RobFro96/Arduino-Mega-6502/eagle-6502/6502_arduino/Version 1 Errata.txt

- Move back USB connector by 3 mm
- Mirror oscillator footprint
- connect PA2 directly to BOOT button
