RobFro96/Arduino-Mega-6502/eagle-6502/base v2/base.pdf

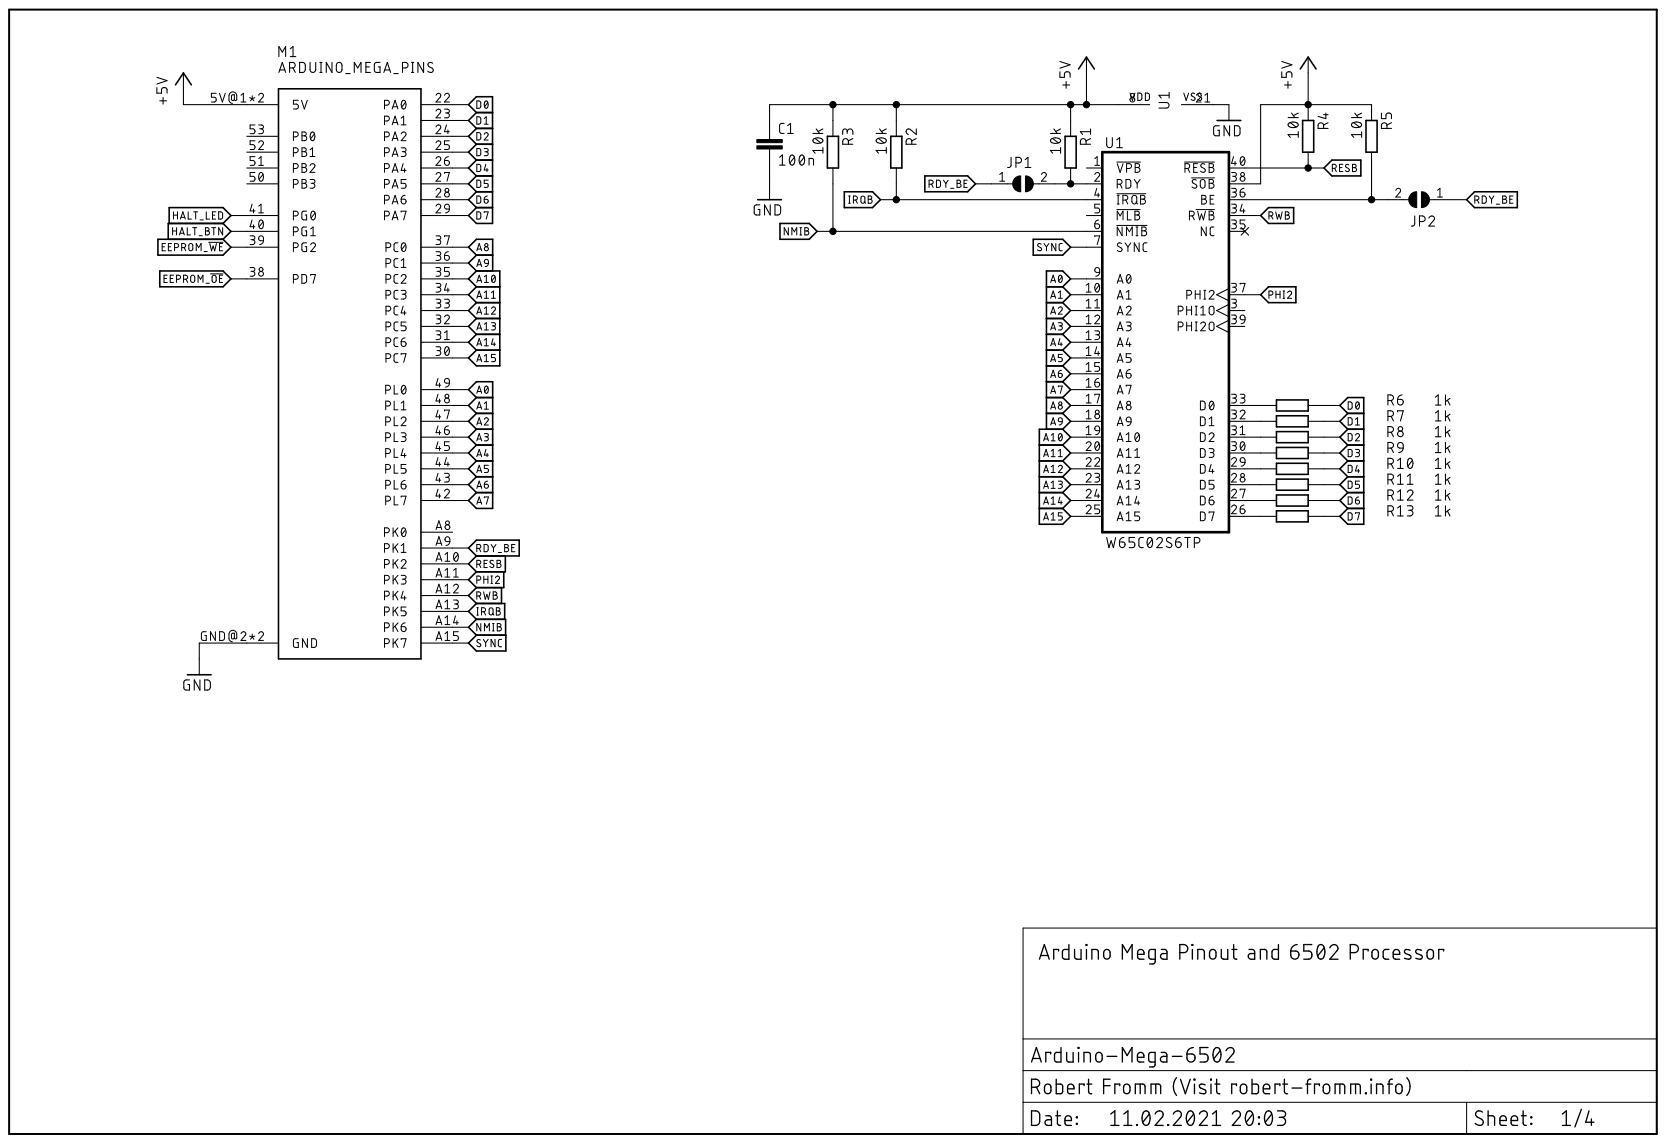
[picture p1: page 1]

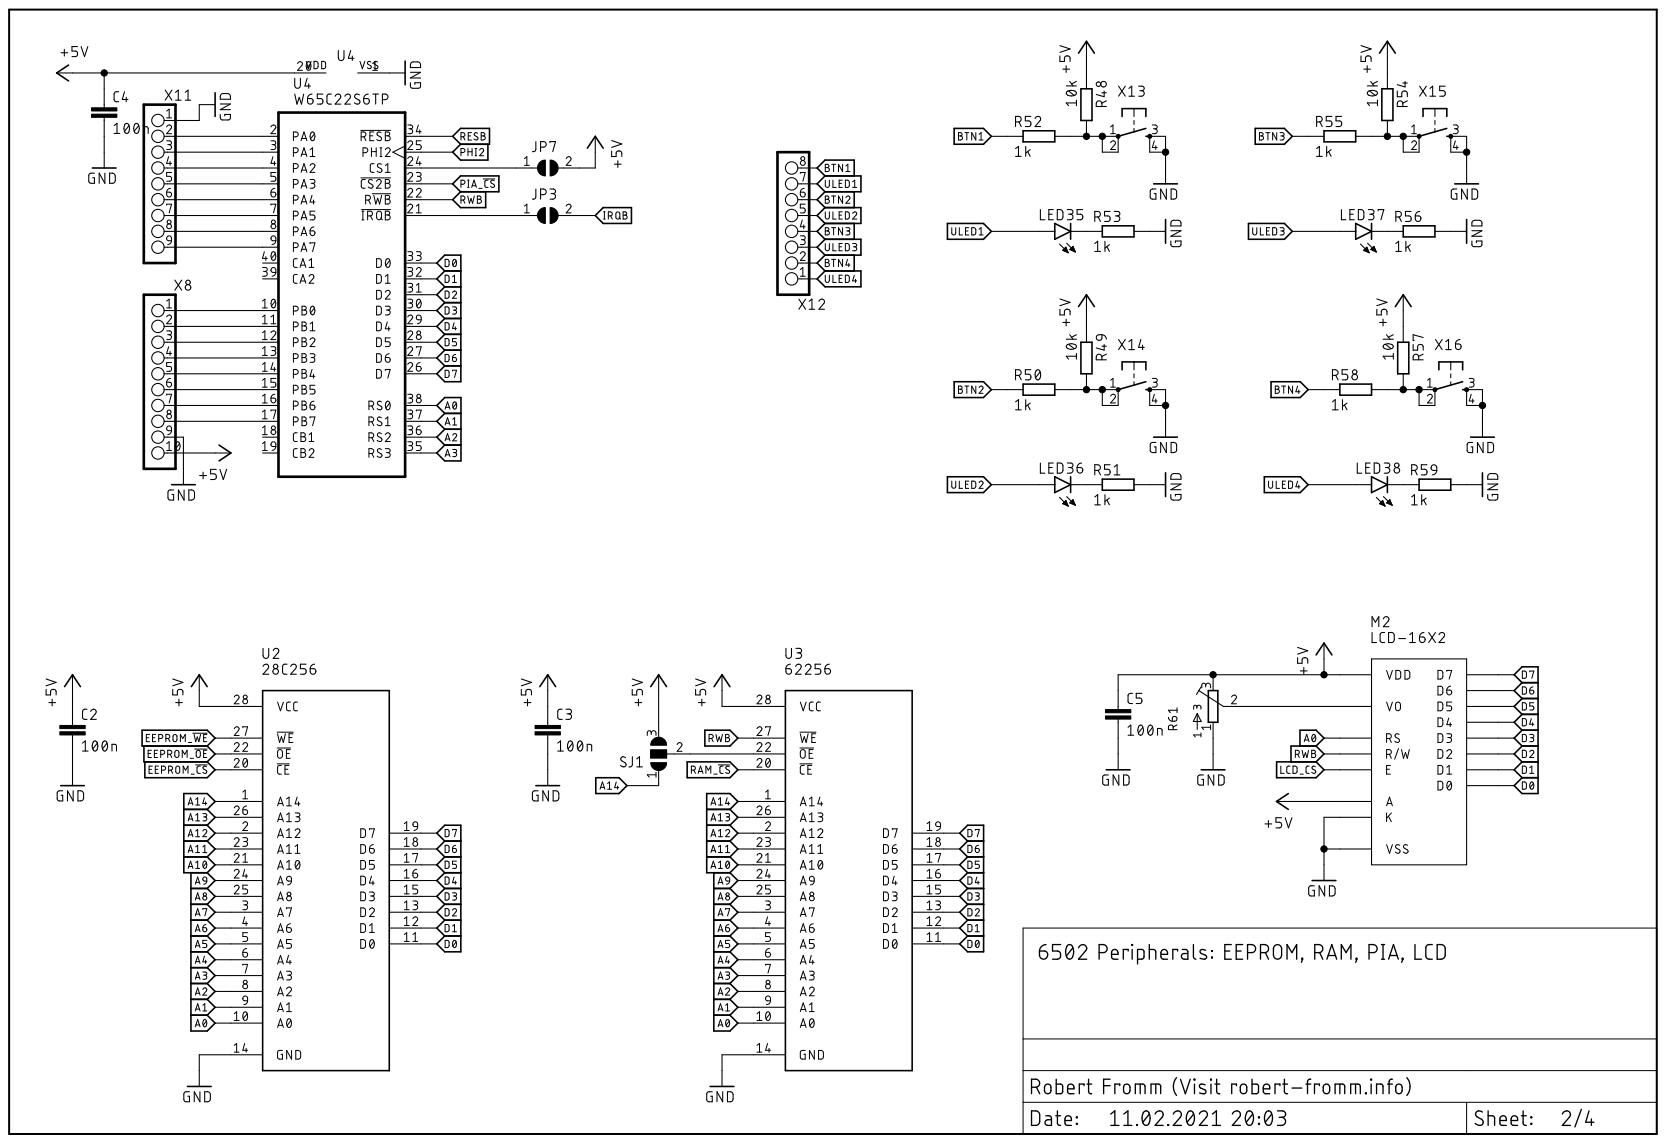
[picture p2: page 2]

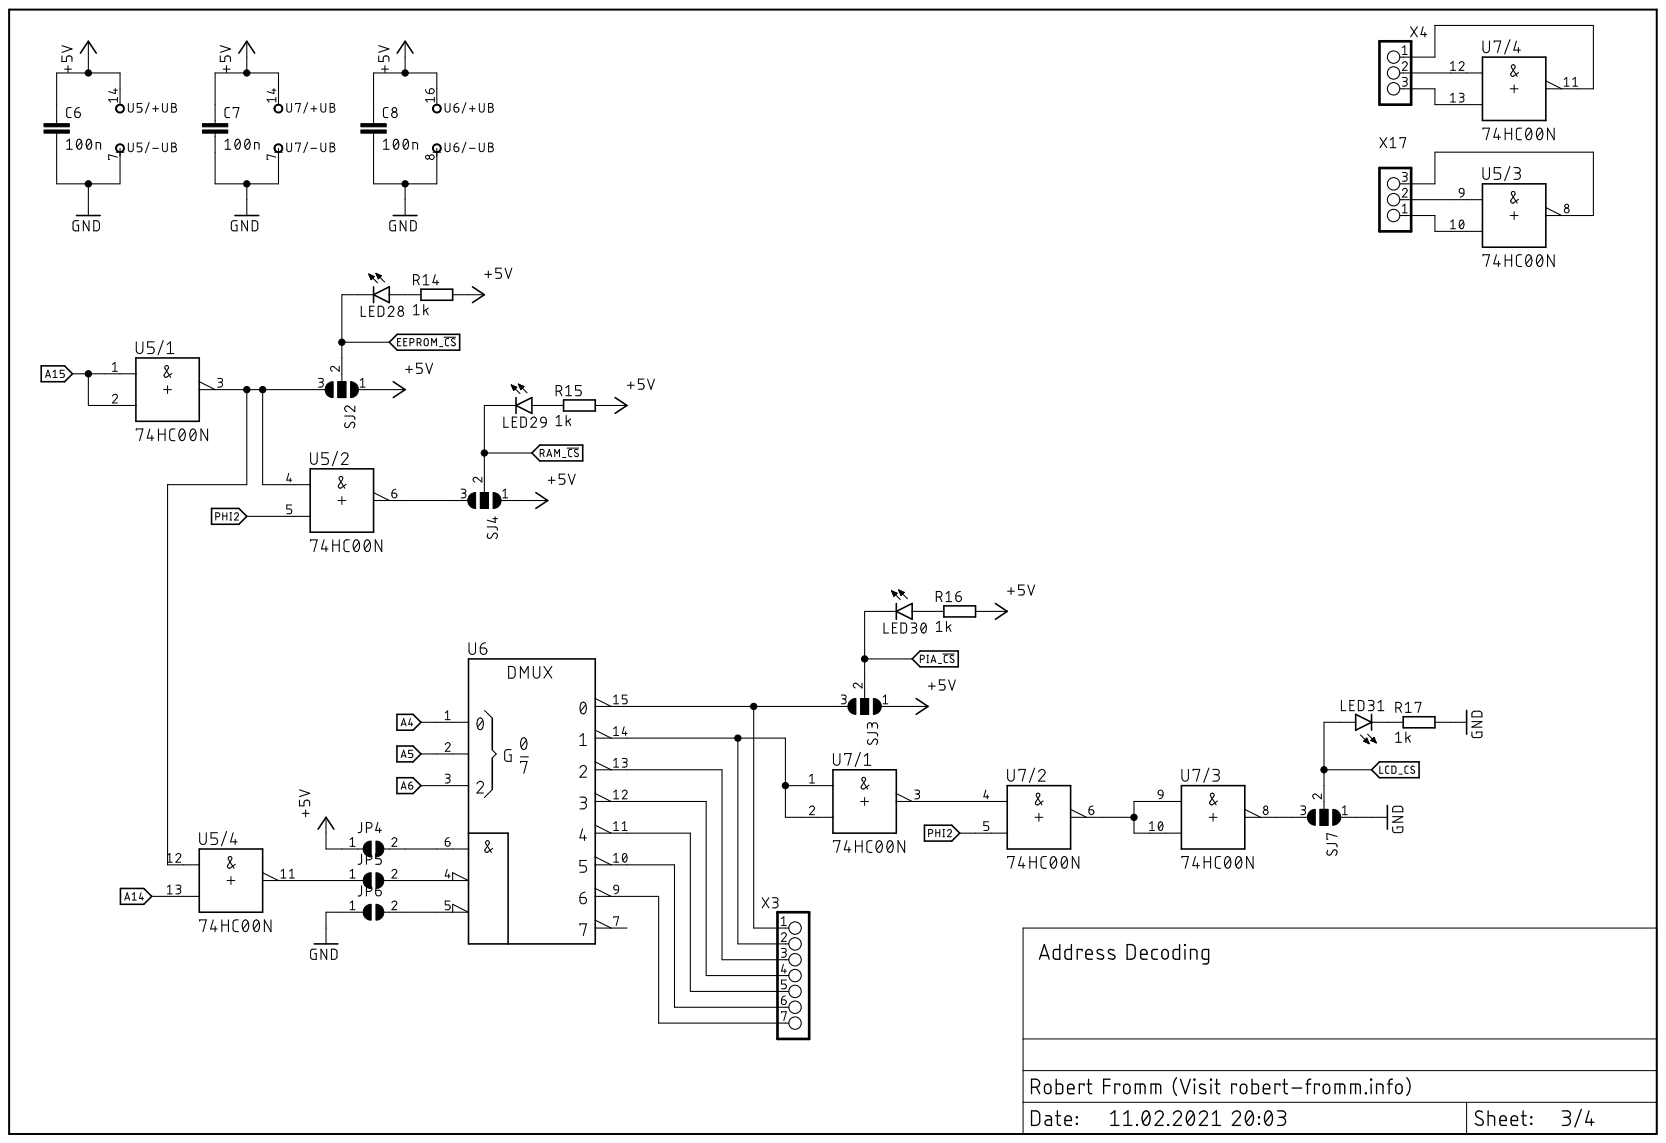
[picture p3: page 3]

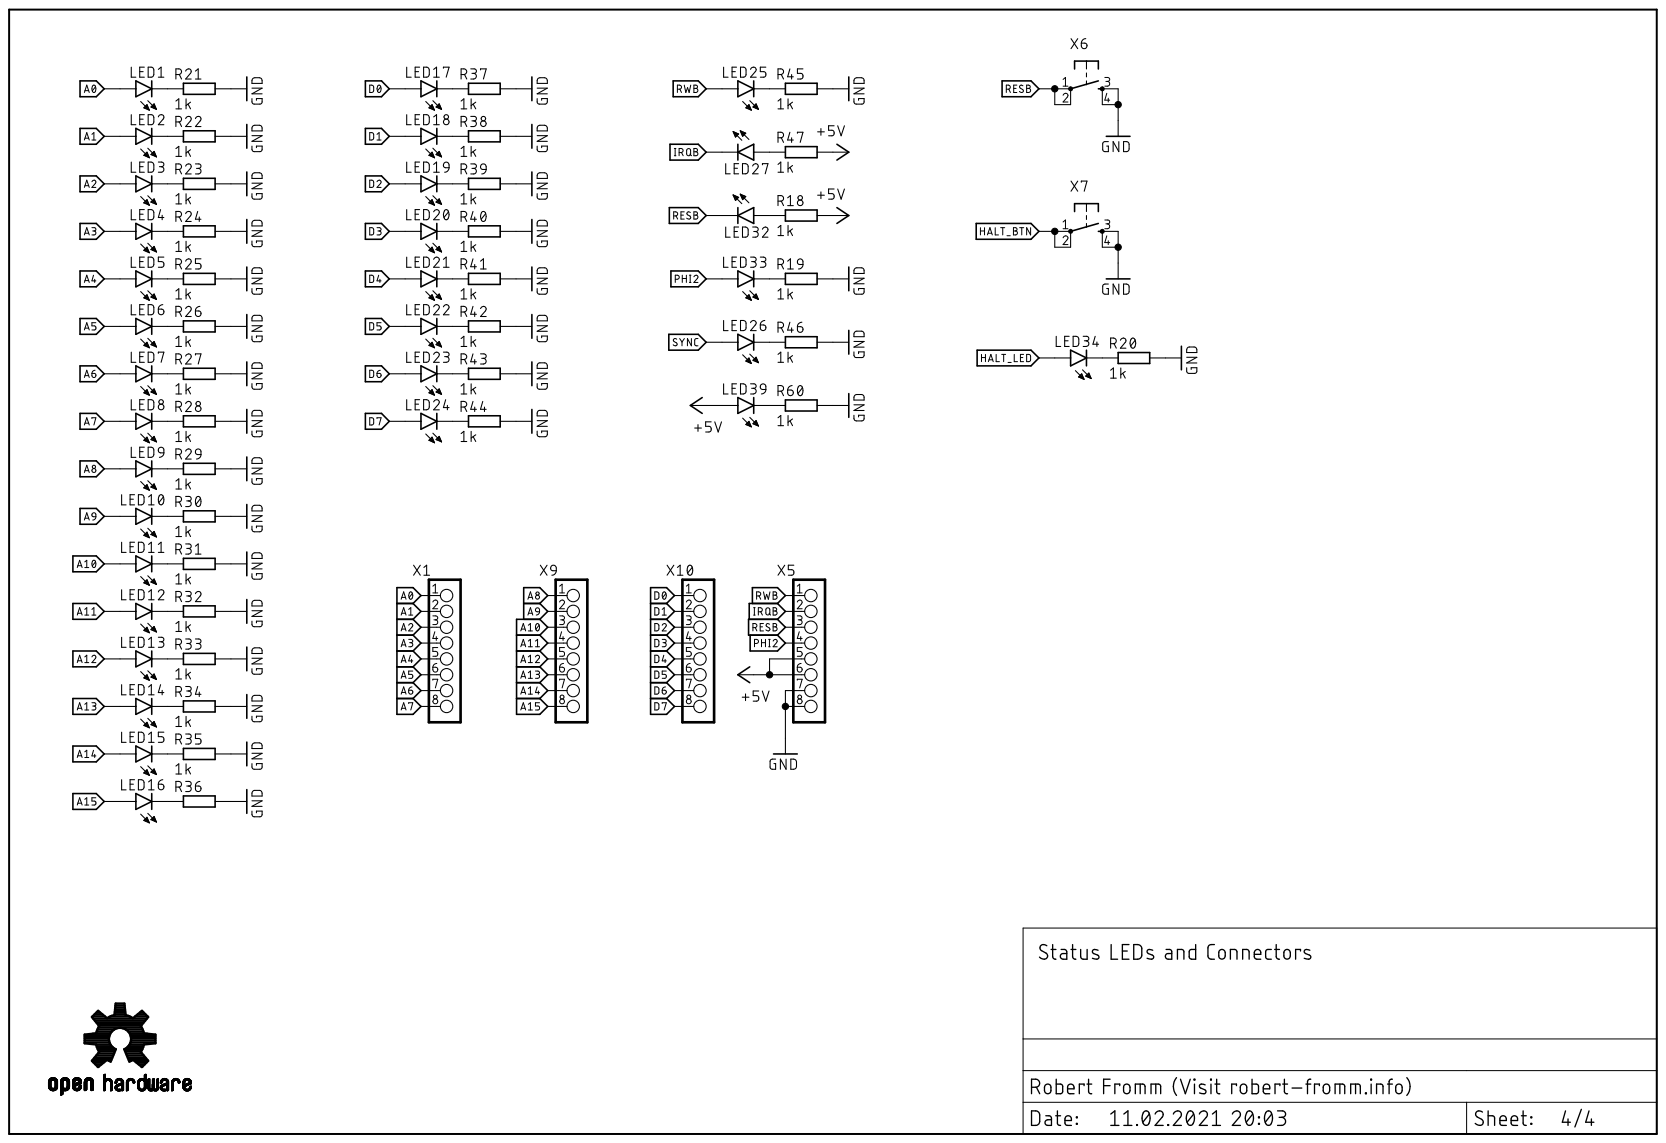
[picture p4: page 4]
