RobFro96/Arduino-Mega-6502/eagle-6502/6502_arduino/6502_arduino.brd

## EAGLE design eagle-6502/6502_arduino/6502_arduino.brd (2024-02-25)

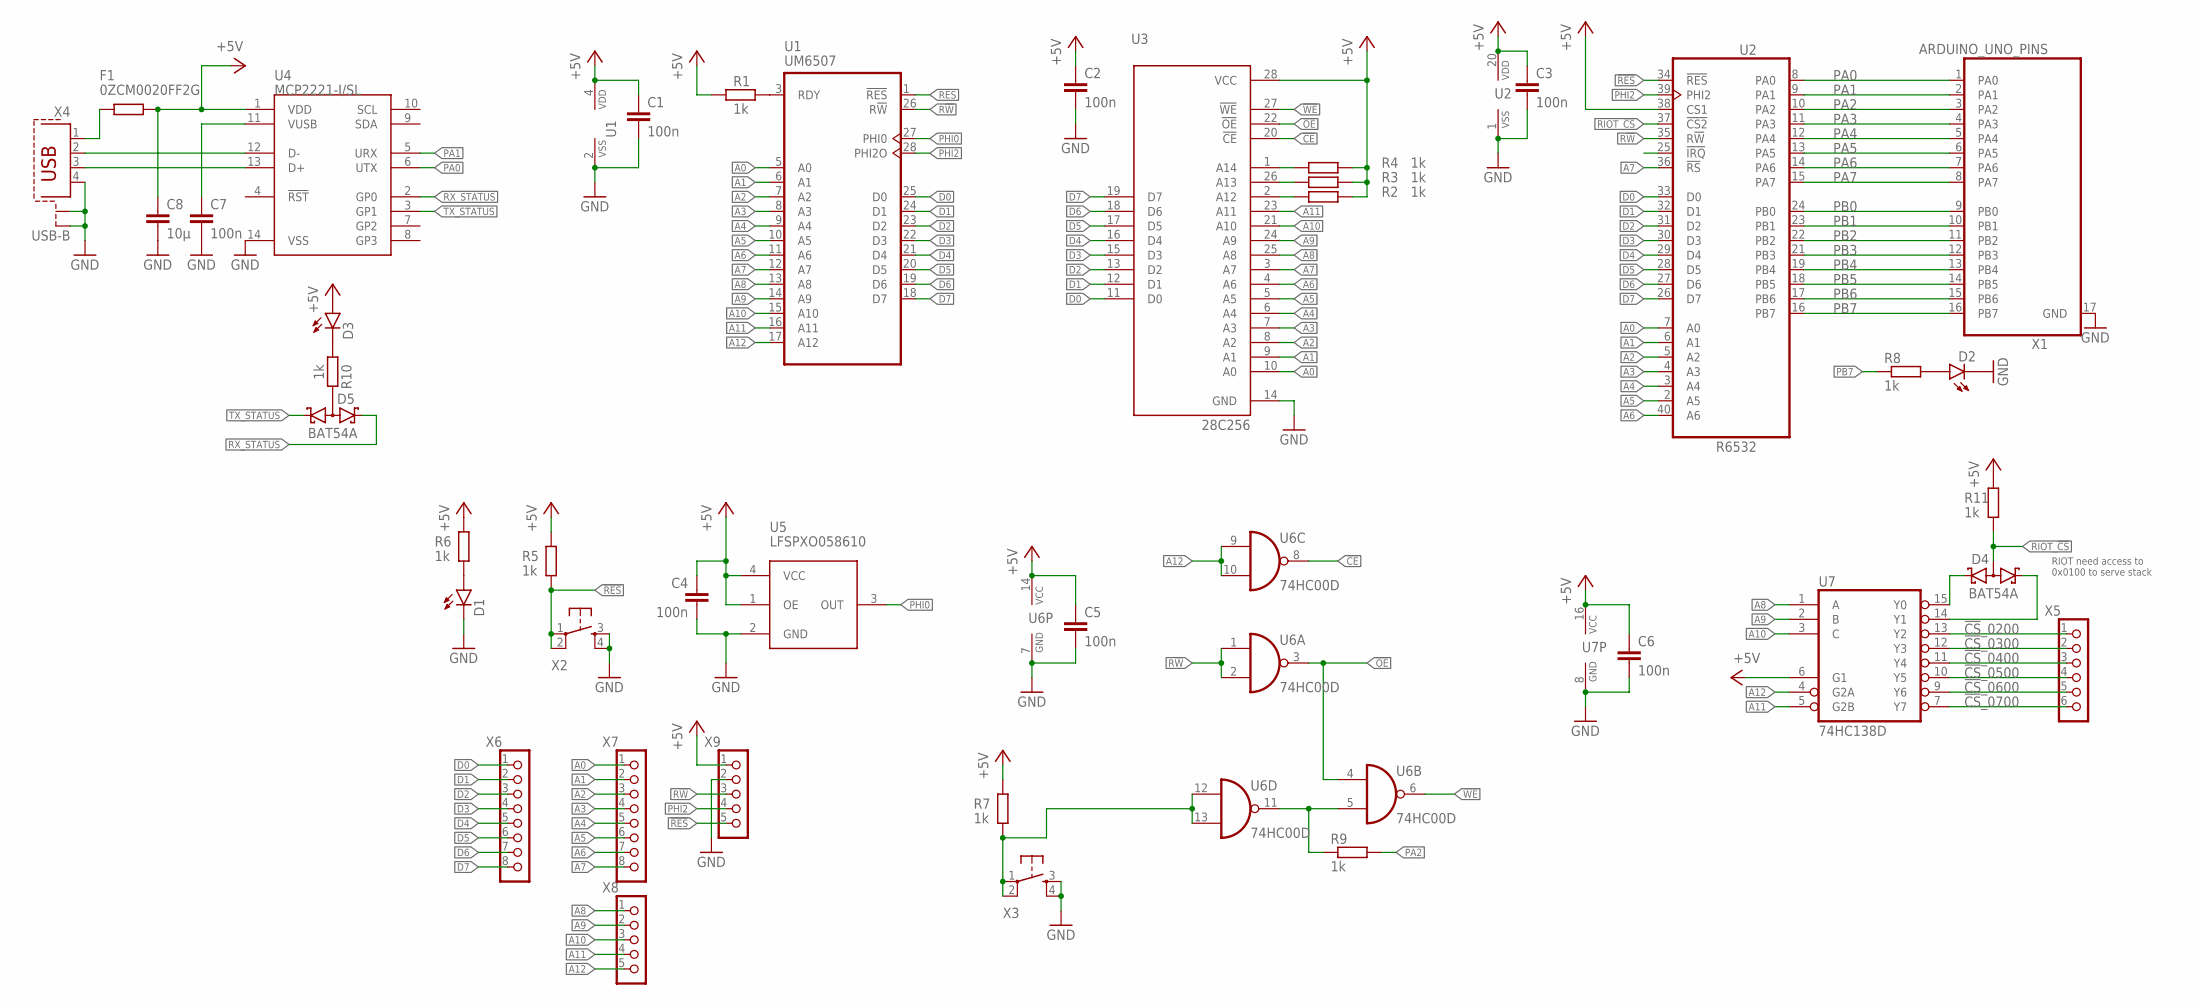
[picture p5: schematic 6502_arduino.sch]

Parts:
C1, C2, C3, C4, C5, C6, C7: 100n; C0805
C8: 10µ; C0805
D1, D2, D3: LED; LED3MM
D4, D5: BAT54A; SOT23
F1: 0ZCM0020FF2G; R0603
R1, R2, R3, R4, R5, R6, R7, R8, R9, R10, R11: 1k; R0805
U1: UM6507; DIL28-6
U2: R6532; DIL40
U3: 28C256; DIL28-6
U4: MCP2221-I/SL; SOIC14
U5: LFSPXO058610
U6: 74HC00D; SO14
U7: 74HC138D; SO16
X1: ARDUINO_UNO_PINS; ARDUINO_R3
X2, X3: TACT_SWITCH; TACTILE_SWITCH_PTH_6.0MM
X4: USB-B; PN61729-S
X5: PINHD_6_RND; 1X06
X6, X7: PINHD_8_RND; 1X08
X8, X9: PINHD_5_RND; 1X05

Connections:
!BOOT: R7.1, U6.12 (I0), U6.13 (I1), X3.1, X3.2
!CE: U3.20 (!CE), U6.8 (O)
!CS!_0200: U7.13 (Y2), X5.1
!CS!_0300: U7.12 (Y3), X5.2
!CS!_0400: U7.11 (Y4), X5.3
!CS!_0500: U7.10 (Y5), X5.4
!CS!_0600: U7.9 (Y6), X5.5
!CS!_0700: U7.7 (Y7), X5.6
!OE: U3.22 (!OE), U6.3 (O), U6.4 (I0)
!RES: R5.1, U1.1 (!RES), U2.34 (!RES), X2.1, X2.2, X9.5
!WE: U3.27 (!WE), U6.6 (O)
+5V: C1.1, C2.1, C3.1, C4.1, C5.1, C6.1, C8.1, D3.A, F1.2, R1.1, R2.2, R3.2, R4.2, R5.2, R6.2, R7.2, R11.2, U1.4 (VDD), U2.20 (VDD), U2.38 (CS1), U3.28 (VCC), U4.1 (VDD), U5.1 (OE), U5.4 (VCC), U6.14 (VCC), U7.6 (G1), U7.16 (VCC), X9.1
A0: U1.5 (A0), U2.7 (A0), U3.10 (A0), X7.1
A1: U1.6 (A1), U2.6 (A1), U3.9 (A1), X7.2
A2: U1.7 (A2), U2.5 (A2), U3.8 (A2), X7.3
A3: U1.8 (A3), U2.4 (A3), U3.7 (A3), X7.4
A4: U1.9 (A4), U2.3 (A4), U3.6 (A4), X7.5
A5: U1.10 (A5), U2.2 (A5), U3.5 (A5), X7.6
A6: U1.11 (A6), U2.40 (A6), U3.4 (A6), X7.7
A7: U1.12 (A7), U2.36 (!RS), U3.3 (A7), X7.8
A8: U1.13 (A8), U3.25 (A8), U7.1 (A), X8.1
A9: U1.14 (A9), U3.24 (A9), U7.2 (B), X8.2
A10: U1.15 (A10), U3.21 (A10), U7.3 (C), X8.3
A11: U1.16 (A11), U3.23 (A11), U7.5 (G2B), X8.4
A12: U1.17 (A12), U6.9 (I0), U6.10 (I1), U7.4 (G2A), X8.5
D0: U1.25 (D0), U2.33 (D0), U3.11 (D0), X6.1
D1: U1.24 (D1), U2.32 (D1), U3.12 (D1), X6.2
D2: U1.23 (D2), U2.31 (D2), U3.13 (D2), X6.3
D3: U1.22 (D3), U2.30 (D3), U3.15 (D3), X6.4
D4: U1.21 (D4), U2.29 (D4), U3.16 (D4), X6.5
D5: U1.20 (D5), U2.28 (D5), U3.17 (D5), X6.6
D6: U1.19 (D6), U2.27 (D6), U3.18 (D6), X6.7
D7: U1.18 (D7), U2.26 (D7), U3.19 (D7), X6.8
GND: C1.2, C2.2, C3.2, C4.2, C5.2, C6.2, C7.2, C8.2, D1.K (C), D2.K (C), U1.2 (VSS), U2.1 (VSS), U3.14 (GND), U4.14 (VSS), U5.2 (GND), U6.7 (GND), U7.8 (GND), X1.17 (GND), X2.3, X2.4, X3.3, X3.4, X4.4, X4.S1, X4.S2, X9.2
unnamed: R1.2, U1.3 (RDY)
unnamed: D1.A, R6.1
unnamed: R9.1, U6.5 (I1), U6.11 (O)
unnamed: D2.A, R8.2
unnamed: U4.12 (D-), X4.2
unnamed: U4.13 (D+), X4.3
unnamed: D3.K (C), R10.1
unnamed: C7.1, U4.11 (VUSB)
unnamed: D5.3 (AA), R10.2
unnamed: F1.1, X4.1
unnamed: D4.1 (K1), U7.15 (Y0)
unnamed: R2.1, U3.2 (A12)
unnamed: R3.1, U3.26 (A13)
unnamed: R4.1, U3.1 (A14)
unnamed: D4.2 (K2), U7.14 (Y1)
PA0: U2.8 (PA0), U4.6 (UTX), X1.1 (PA0)
PA1: U2.9 (PA1), U4.5 (URX), X1.2 (PA1)
PA2: R9.2, U2.10 (PA2), X1.3 (PA2)
PA3: U2.11 (PA3), X1.4 (PA3)
PA4: U2.12 (PA4), X1.5 (PA4)
PA5: U2.13 (PA5), X1.6 (PA5)
PA6: U2.14 (PA6), X1.7 (PA6)
PA7: U2.15 (PA7), X1.8 (PA7)
PB0: U2.24 (PB0), X1.9 (PB0)
PB1: U2.23 (PB1), X1.10 (PB1)
PB2: U2.22 (PB2), X1.11 (PB2)
PB3: U2.21 (PB3), X1.12 (PB3)
PB4: U2.19 (PB4), X1.13 (PB4)
PB5: U2.18 (PB5), X1.14 (PB5)
PB6: U2.17 (PB6), X1.15 (PB6)
PB7: R8.1, U2.16 (PB7), X1.16 (PB7)
PHI0: U1.27 (PHI0), U5.3 (OUT)
PHI2: U1.28 (PHI2O), U2.39 (PHI2), X9.4
R!W: U1.26 (R!W), U2.35 (R!W), U6.1 (I0), U6.2 (I1), X9.3
RIOT_!CS: D4.3 (AA), R11.1, U2.37 (!CS2)
RX_STATUS: D5.2 (K2), U4.2 (GP0)
TX_STATUS: D5.1 (K1), U4.3 (GP1)

Notes on the sheet:
RIOT need access to 0x0100 to serve stack

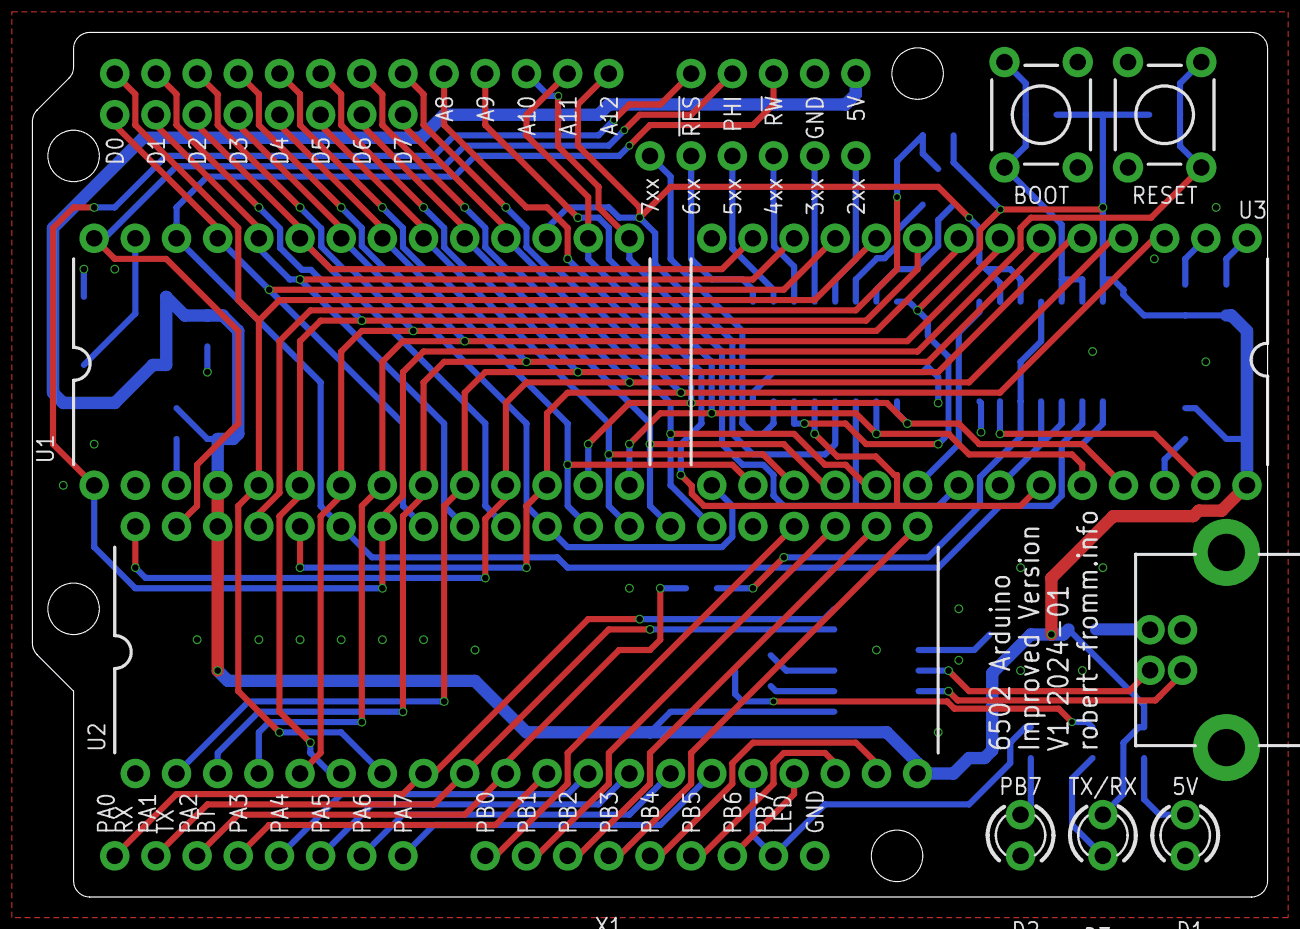
[picture p6: board 6502_arduino.brd from above]

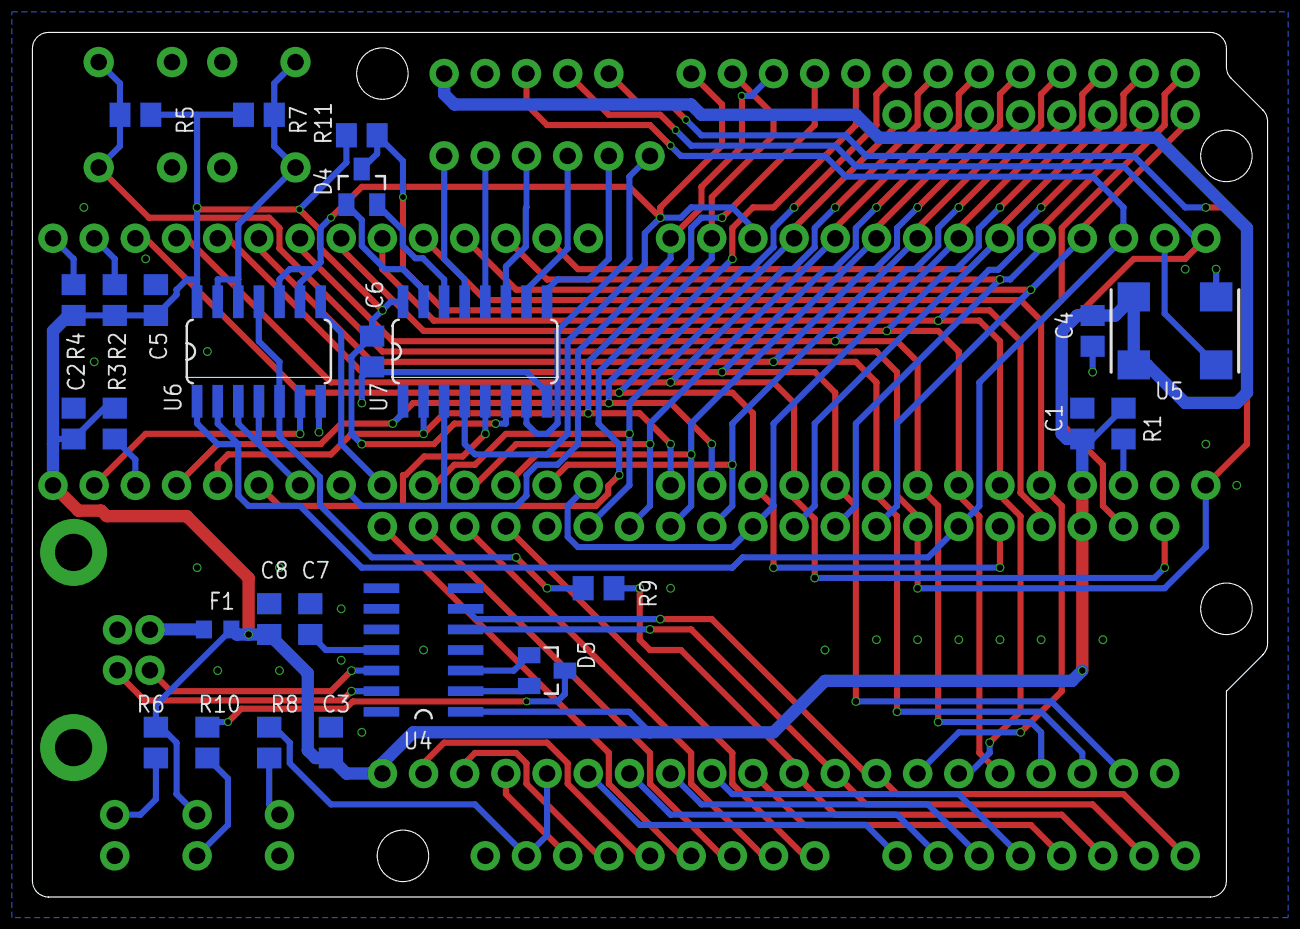
[picture p7: board 6502_arduino.brd from below]

Board: 2 copper layers, 76.2 x 53.3 mm, 41 parts (26 on the bottom side), 71 nets.
