RobFro96/Arduino-Mega-6502/eagle-6502/eater_eeprom/eater_eeprom.brd

## EAGLE design eagle-6502/eater_eeprom/eater_eeprom.brd (2023-12-07)

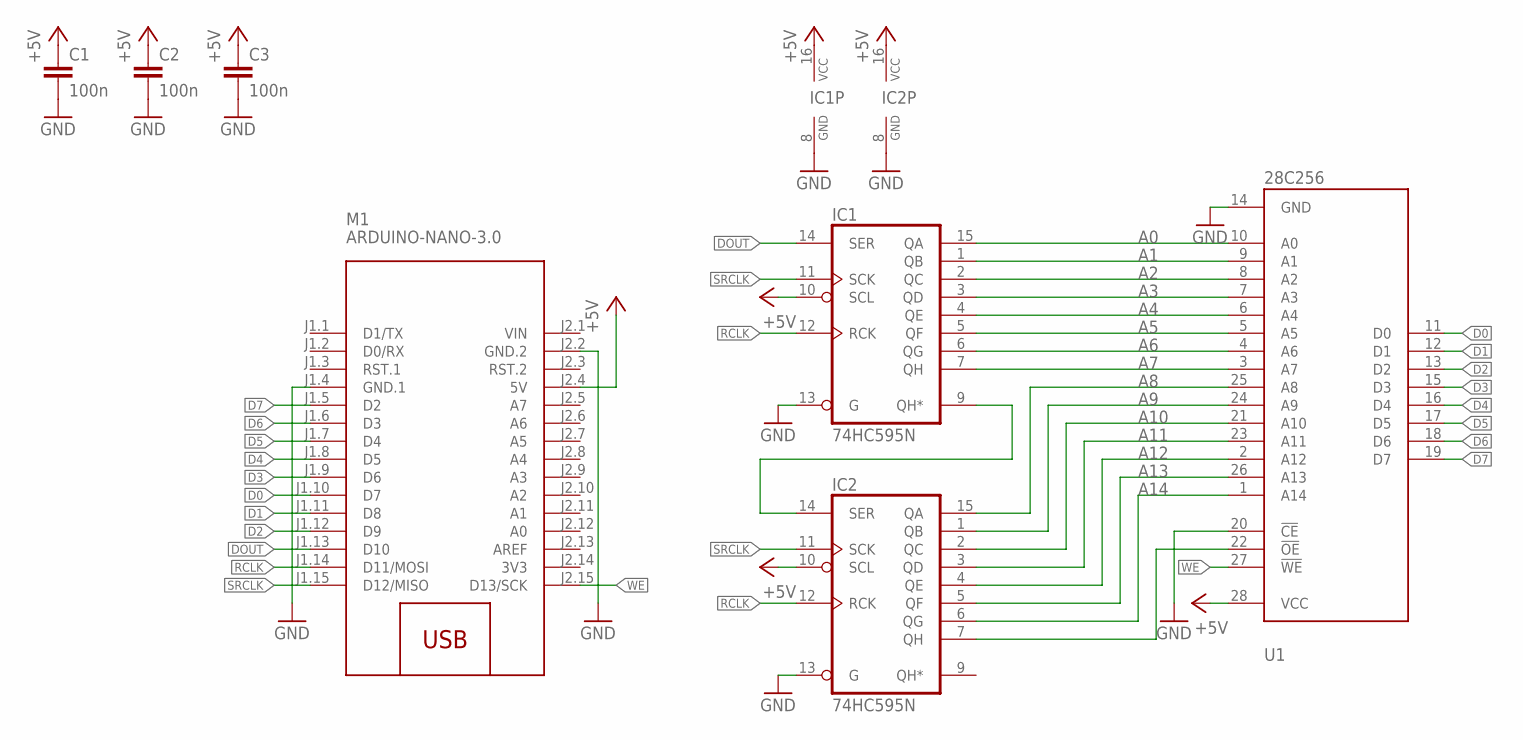
[picture p8: schematic eater_eeprom.sch]

Parts:
C1, C2, C3: 100n; C0805
IC1, IC2: 74HC595N; DIL16
M1: ARDUINO-NANO-3.0
U1: 28C256; DIL28-6

Connections:
3V3: M1.J2.14 (3V3)
+5V: C1.1, C2.1, C3.1, IC1.10 (SCL), IC1.16 (VCC), IC2.10 (SCL), IC2.16 (VCC), M1.J2.4 (5V), U1.28 (VCC)
A0: IC1.15 (QA), U1.10 (A0)
A1: IC1.1 (QB), U1.9 (A1)
A2: IC1.2 (QC), U1.8 (A2)
A3: IC1.3 (QD), U1.7 (A3)
A4: IC1.4 (QE), U1.6 (A4)
A5: IC1.5 (QF), U1.5 (A5)
A6: IC1.6 (QG), U1.4 (A6)
A7: IC1.7 (QH), U1.3 (A7)
A8: IC2.15 (QA), U1.25 (A8)
A9: IC2.1 (QB), U1.24 (A9)
A10: IC2.2 (QC), U1.21 (A10)
A11: IC2.3 (QD), U1.23 (A11)
A12: IC2.4 (QE), U1.2 (A12)
A13: IC2.5 (QF), U1.26 (A13)
A14: IC2.6 (QG), U1.1 (A14)
D0: M1.J1.10 (D7), U1.11 (D0)
D1: M1.J1.11 (D8), U1.12 (D1)
D2: M1.J1.12 (D9), U1.13 (D2)
D3: M1.J1.9 (D6), U1.15 (D3)
D4: M1.J1.8 (D5), U1.16 (D4)
D5: M1.J1.7 (D4), U1.17 (D5)
D6: M1.J1.6 (D3), U1.18 (D6)
D7: M1.J1.5 (D2), U1.19 (D7)
DOUT: IC1.14 (SER), M1.J1.13 (D10)
GND: C1.2, C2.2, C3.2, IC1.8 (GND), IC1.13 (G), IC2.8 (GND), IC2.13 (G), M1.J1.4 (GND.1), M1.J2.2 (GND.2), U1.14 (GND), U1.20 (!CE)
unnamed: IC1.9 (QH*), IC2.14 (SER)
unnamed: IC2.7 (QH), U1.22 (!OE)
RCLK: IC1.12 (RCK), IC2.12 (RCK), M1.J1.14 (D11/MOSI)
SRCLK: IC1.11 (SCK), IC2.11 (SCK), M1.J1.15 (D12/MISO)
VIN: M1.J2.1 (VIN)
WE: M1.J2.15 (D13/SCK), U1.27 (!WE)

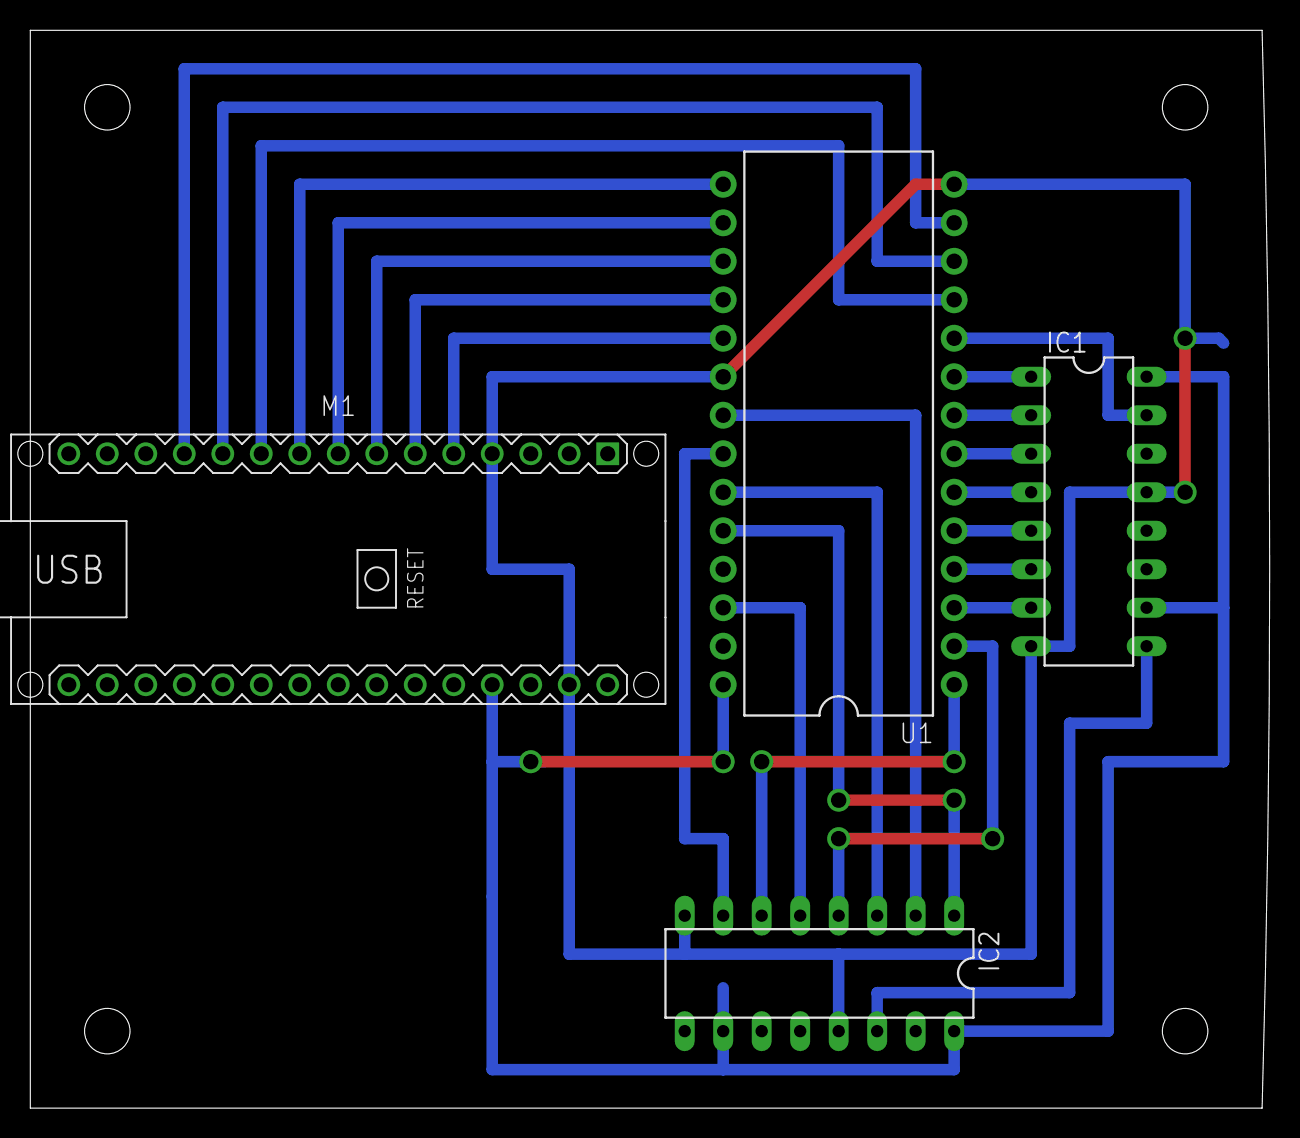
[picture p9: board eater_eeprom.brd from above]

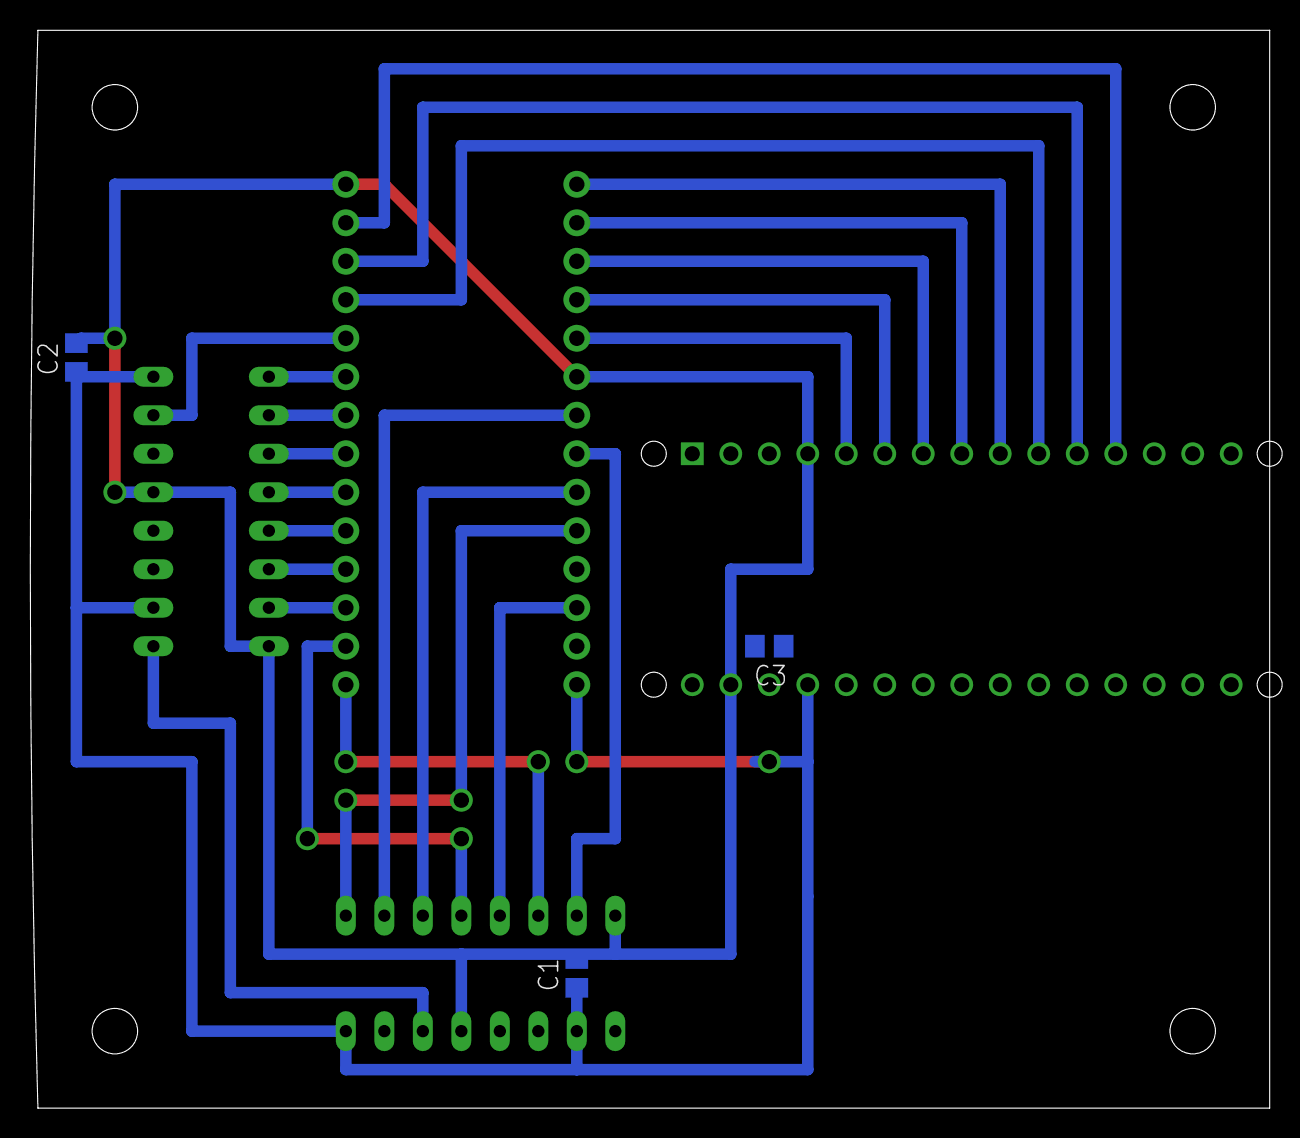
[picture p10: board eater_eeprom.brd from below]

Board: 2 copper layers, 81.8 x 71.1 mm, 7 parts (3 on the bottom side), 31 nets.
