RobFro96/Arduino-Mega-6502/eagle-6502/base v2/base.brd

## EAGLE design eagle-6502/base v2/base.brd (2023-12-06)

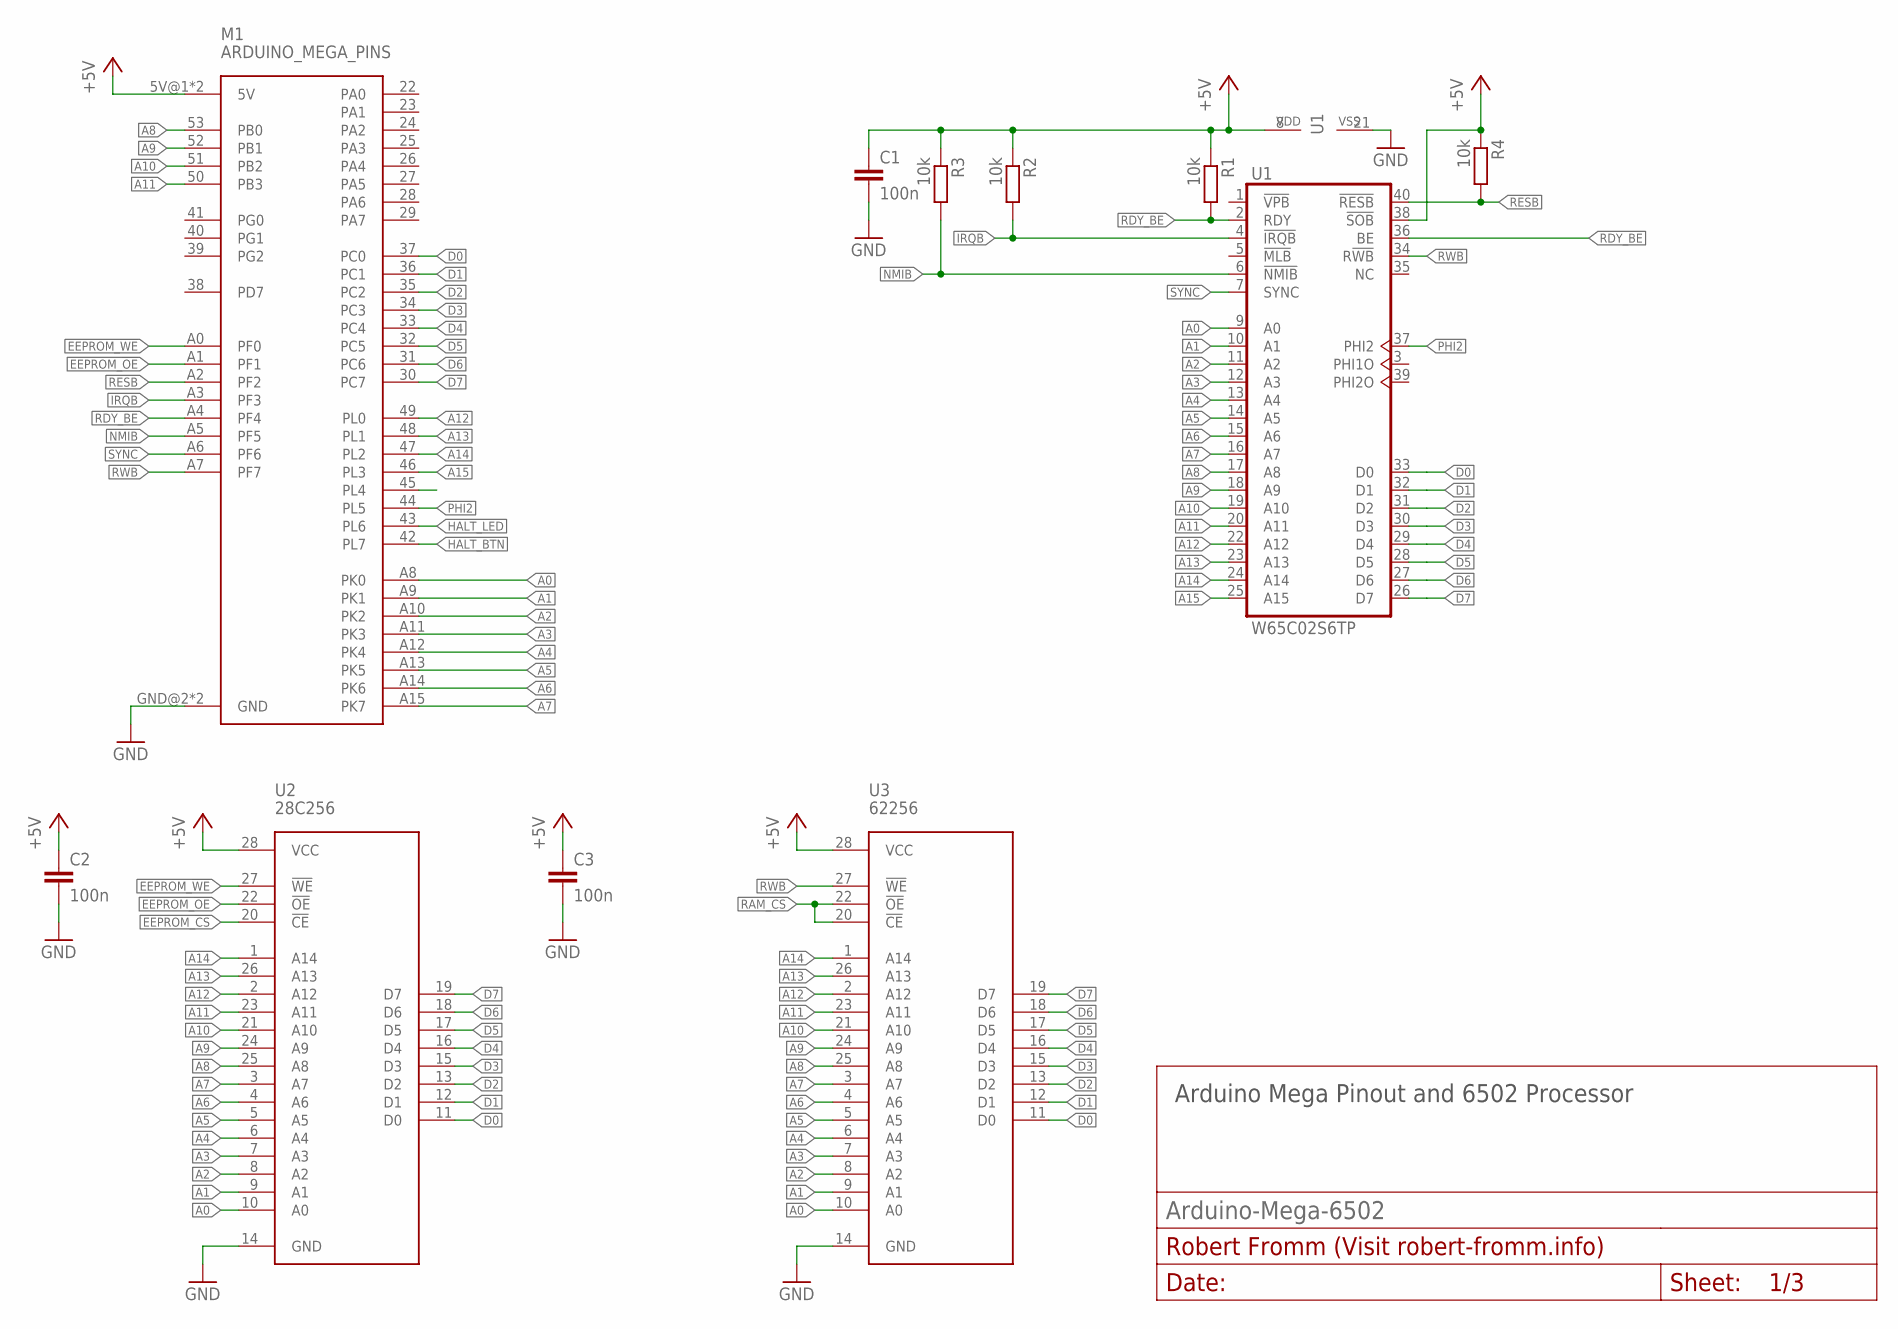
[picture p11: schematic base.sch, sheet 1]

Parts:
C1, C2, C3: 100n; C0805
M1: ARDUINO_MEGA_PINS
R1, R2, R3, R4: 10k; R0805
U1: W65C02S6TP; DIL40
U2: 28C256; DIL28-6
U3: 62256; DIL28-6

Connections:
+5V: C1.1, C2.1, C3.1, M1.5V@1 (5V), M1.5V@2 (5V), R1.1, R2.1, R3.1, R4.1, U1.8 (VDD), U1.38 (!SOB), U2.28 (VCC), U3.28 (VCC); also elsewhere on the board
A0: M1.A8 (PK0), U1.9 (A0), U2.10 (A0), U3.10 (A0); also elsewhere on the board
A1: M1.A9 (PK1), U1.10 (A1), U2.9 (A1), U3.9 (A1); also elsewhere on the board
A2: M1.A10 (PK2), U1.11 (A2), U2.8 (A2), U3.8 (A2); also elsewhere on the board
A3: M1.A11 (PK3), U1.12 (A3), U2.7 (A3), U3.7 (A3); also elsewhere on the board
A4: M1.A12 (PK4), U1.13 (A4), U2.6 (A4), U3.6 (A4); also elsewhere on the board
A5: M1.A13 (PK5), U1.14 (A5), U2.5 (A5), U3.5 (A5); also elsewhere on the board
A6: M1.A14 (PK6), U1.15 (A6), U2.4 (A6), U3.4 (A6); also elsewhere on the board
A7: M1.A15 (PK7), U1.16 (A7), U2.3 (A7), U3.3 (A7); also elsewhere on the board
A8: M1.53 (PB0), U1.17 (A8), U2.25 (A8), U3.25 (A8); also elsewhere on the board
A9: M1.52 (PB1), U1.18 (A9), U2.24 (A9), U3.24 (A9); also elsewhere on the board
A10: M1.51 (PB2), U1.19 (A10), U2.21 (A10), U3.21 (A10); also elsewhere on the board
A11: M1.50 (PB3), U1.20 (A11), U2.23 (A11), U3.23 (A11); also elsewhere on the board
A12: M1.49 (PL0), U1.22 (A12), U2.2 (A12), U3.2 (A12); also elsewhere on the board
A13: M1.48 (PL1), U1.23 (A13), U2.26 (A13), U3.26 (A13); also elsewhere on the board
A14: M1.47 (PL2), U1.24 (A14), U2.1 (A14), U3.1 (A14); also elsewhere on the board
A15: M1.46 (PL3), U1.25 (A15); also elsewhere on the board
D0: M1.37 (PC0), U1.33 (D0), U2.11 (D0), U3.11 (D0); also elsewhere on the board
D1: M1.36 (PC1), U1.32 (D1), U2.12 (D1), U3.12 (D1); also elsewhere on the board
D2: M1.35 (PC2), U1.31 (D2), U2.13 (D2), U3.13 (D2); also elsewhere on the board
D3: M1.34 (PC3), U1.30 (D3), U2.15 (D3), U3.15 (D3); also elsewhere on the board
D4: M1.33 (PC4), U1.29 (D4), U2.16 (D4), U3.16 (D4); also elsewhere on the board
D5: M1.32 (PC5), U1.28 (D5), U2.17 (D5), U3.17 (D5); also elsewhere on the board
D6: M1.31 (PC6), U1.27 (D6), U2.18 (D6), U3.18 (D6); also elsewhere on the board
D7: M1.30 (PC7), U1.26 (D7), U2.19 (D7), U3.19 (D7); also elsewhere on the board
EEPROM_!CS: U2.20 (!CE); also elsewhere on the board
EEPROM_!OE: M1.A1 (PF1), U2.22 (!OE)
EEPROM_!WE: M1.A0 (PF0), U2.27 (!WE)
GND: C1.2, C2.2, C3.2, M1.GND@2 (GND), M1.GND@3 (GND), U1.21 (VSS), U2.14 (GND), U3.14 (GND); also elsewhere on the board
HALT_BTN: M1.42 (PL7); also elsewhere on the board
HALT_LED: M1.43 (PL6); also elsewhere on the board
IRQB: M1.A3 (PF3), R2.2, U1.4 (!IRQB); also elsewhere on the board
NMIB: M1.A5 (PF5), R3.2, U1.6 (!NMIB); also elsewhere on the board
PHI2: M1.44 (PL5), U1.37 (PHI2); also elsewhere on the board
RAM_!CS: U3.20 (!CE), U3.22 (!OE); also elsewhere on the board
RDY_BE: M1.A4 (PF4), R1.2, U1.2 (RDY), U1.36 (BE)
RESB: M1.A2 (PF2), R4.2, U1.40 (!RESB); also elsewhere on the board
RWB: M1.A7 (PF7), U1.34 (R!WB), U3.27 (!WE); also elsewhere on the board
SYNC: M1.A6 (PF6), U1.7 (SYNC); also elsewhere on the board

Notes on the sheet:
Arduino Mega Pinout and 6502 Processor

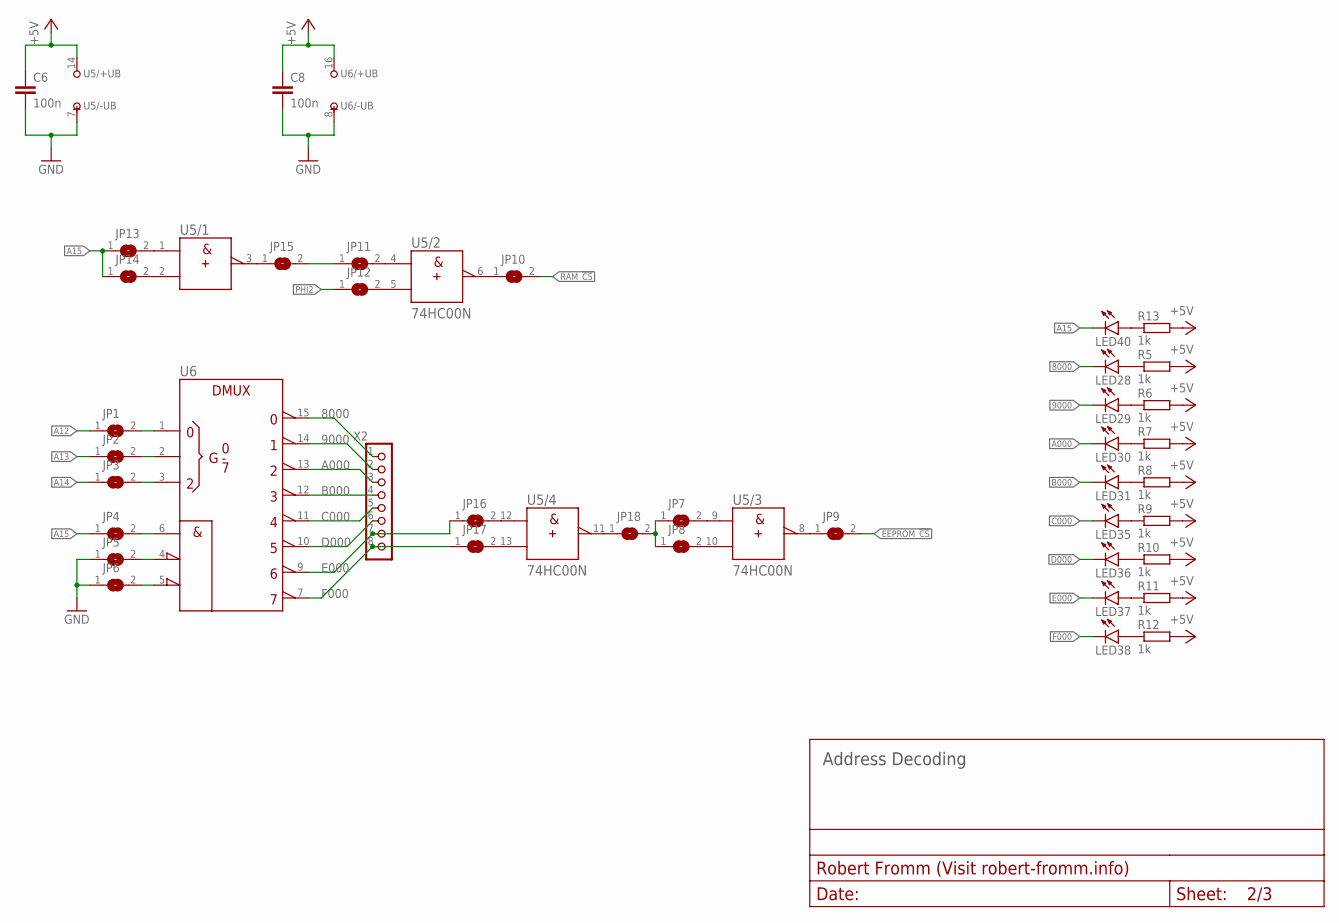
[picture p12: schematic base.sch, sheet 2]

Parts:
C6, C8: 100n; C0805
JP1, JP2, JP3, JP4, JP5, JP6, JP7, JP8, JP9, JP10, JP11, JP12, JP13, JP14, JP15, JP16, JP17, JP18: SJ
LED28, LED29, LED30, LED31, LED35, LED36, LED37, LED38, LED40: LEDSML0805; SML0805
R5, R6, R7, R8, R9, R10, R11, R12, R13: 1k; R0805
U5: 74HC00N; DIL14
U6: 74138N; DIL16
X2: PINHD_8_RND; 1X08

Connections:
8000: LED28.C, U6.15 (Y0), X2.1
9000: LED29.C, U6.14 (Y1), X2.2
+5V: C6.1, C8.1, R5.2, R6.2, R7.2, R8.2, R9.2, R10.2, R11.2, R12.2, R13.2, U5.14 (+UB), U6.16 (+UB); also elsewhere on the board
A000: LED30.C, U6.13 (Y2), X2.3
A12: JP1.1; also elsewhere on the board
A13: JP2.1; also elsewhere on the board
A14: JP3.1; also elsewhere on the board
A15: JP4.1, JP13.1, JP14.1, LED40.C; also elsewhere on the board
B000: LED31.C, U6.12 (Y3), X2.4
C000: LED35.C, U6.11 (Y4), X2.5
D000: LED36.C, U6.10 (Y5), X2.6
E000: JP16.1, LED37.C, U6.9 (Y6), X2.7
EEPROM_!CS: JP9.2; also elsewhere on the board
F000: JP17.1, LED38.C, U6.7 (Y7), X2.8
GND: C6.2, C8.2, JP5.1, JP6.1, U5.7 (-UB), U6.8 (-UB); also elsewhere on the board
unnamed: LED40.A, R13.1
unnamed: JP7.2, U5.9 (A)
unnamed: JP8.2, U5.10 (B)
unnamed: JP9.1, U5.8 (Y)
unnamed: JP1.2, U6.1 (A)
unnamed: JP2.2, U6.2 (B)
unnamed: JP3.2, U6.3 (C)
unnamed: JP5.2, U6.4 (!G2A)
unnamed: JP6.2, U6.5 (!G2B)
unnamed: JP4.2, U6.6 (G1)
unnamed: JP17.2, U5.13 (B)
unnamed: JP10.1, U5.6 (Y)
unnamed: JP13.2, U5.1 (A)
unnamed: JP14.2, U5.2 (B)
unnamed: JP15.1, U5.3 (Y)
unnamed: JP18.1, U5.11 (Y)
unnamed: JP11.1, JP15.2
unnamed: JP16.2, U5.12 (A)
unnamed: JP7.1, JP8.1, JP18.2
unnamed: JP11.2, U5.4 (A)
unnamed: JP12.2, U5.5 (B)
unnamed: LED28.A, R5.1
unnamed: LED29.A, R6.1
unnamed: LED30.A, R7.1
unnamed: LED31.A, R8.1
unnamed: LED35.A, R9.1
unnamed: LED36.A, R10.1
unnamed: LED37.A, R11.1
unnamed: LED38.A, R12.1
PHI2: JP12.1; also elsewhere on the board
RAM_!CS: JP10.2; also elsewhere on the board

Notes on the sheet:
Address Decoding
