RobFro96/Arduino-Mega-6502/eagle-6502/base v2/base.brd

## EAGLE design eagle-6502/base v2/base.brd (continued)

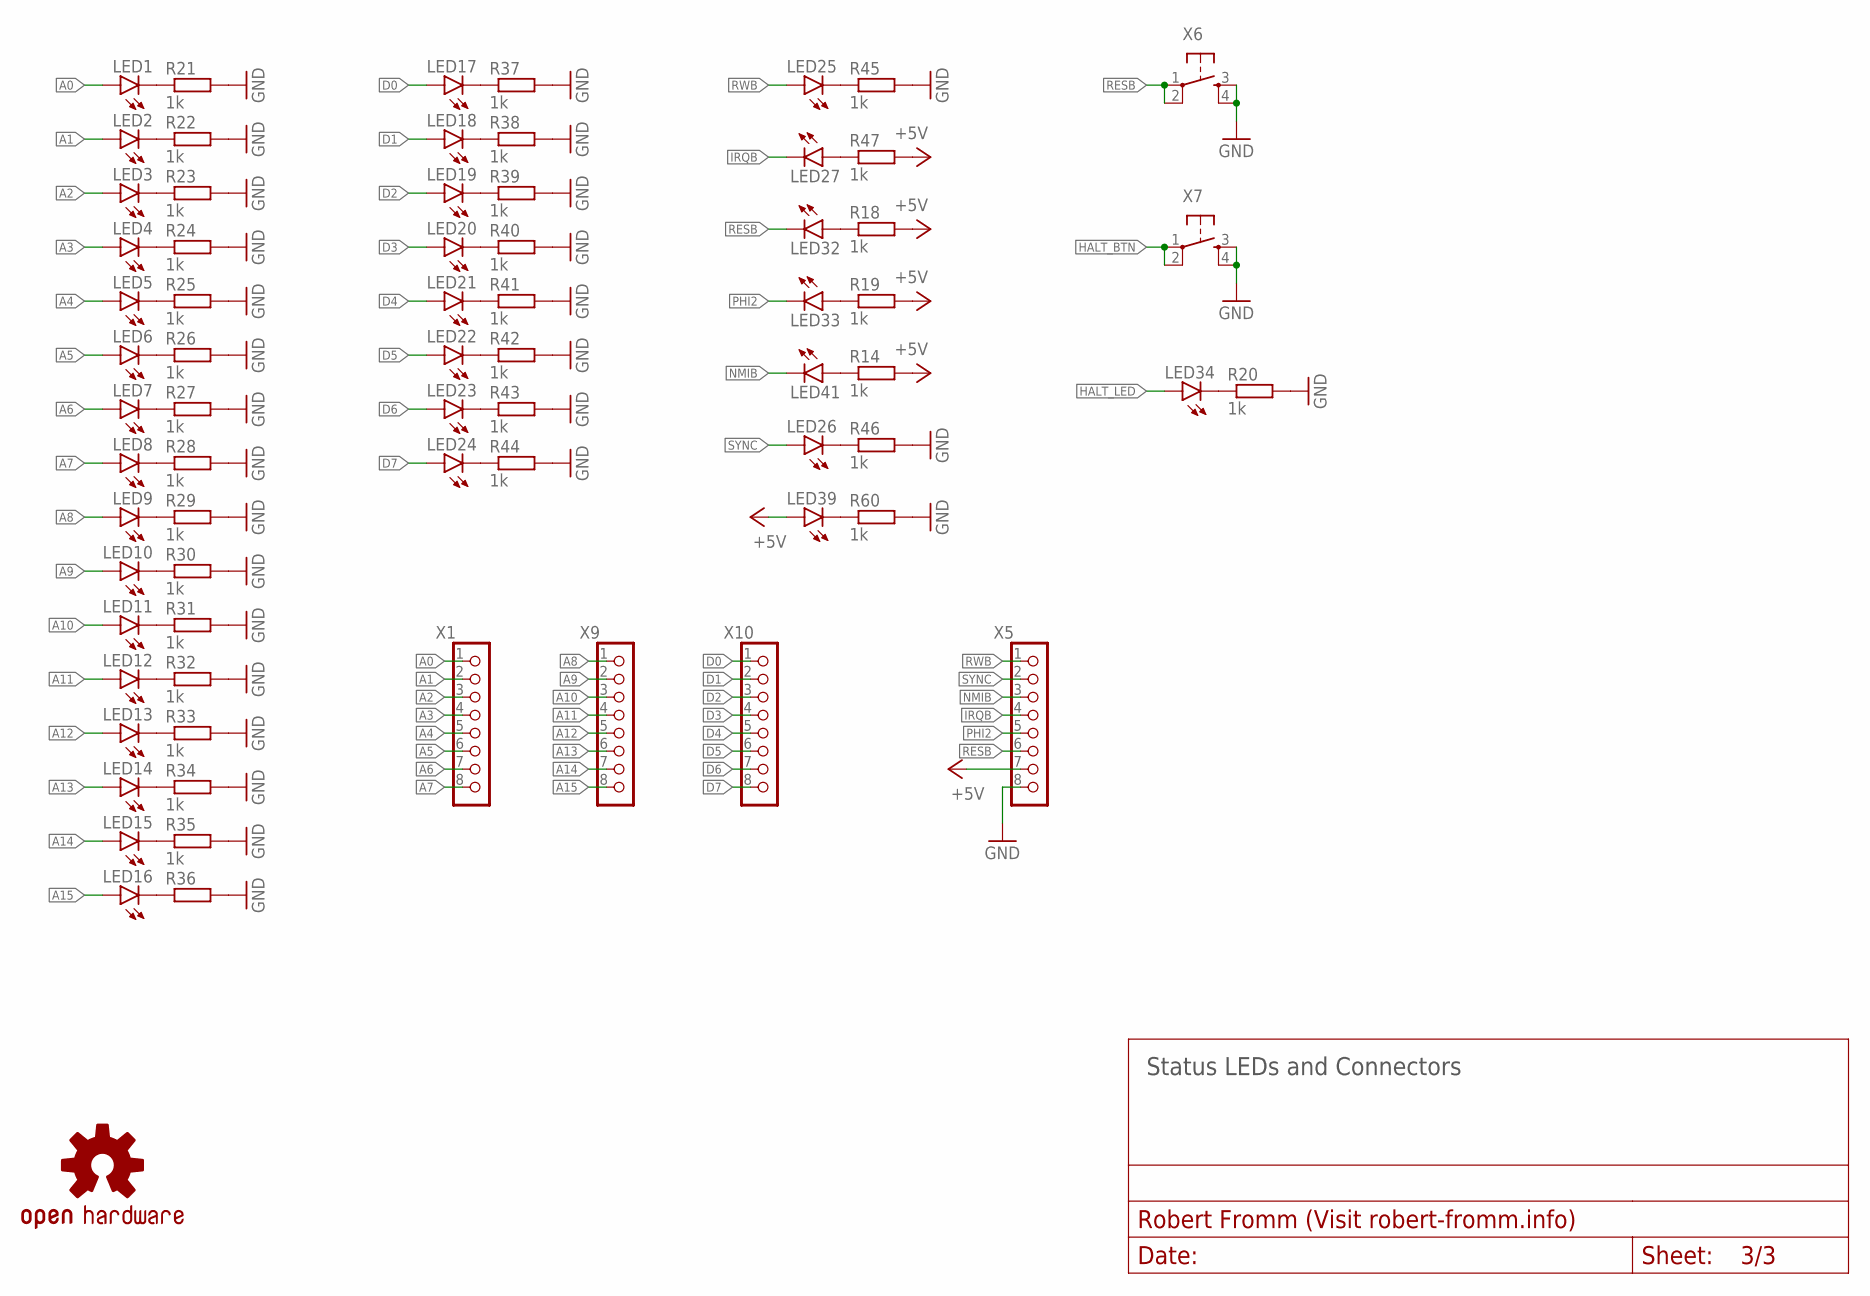
[picture p13: schematic base.sch, sheet 3]

Parts:
LED1, LED2, LED3, LED4, LED5, LED6, LED7, LED8, LED9, LED10, LED11, LED12, LED13, LED14, LED15, LED16, LED17, LED18, LED19, LED20, LED21, LED22, LED23, LED24, LED25, LED26, LED27, LED32, LED33, LED34, LED39, LED41: LEDSML0805; SML0805
LOGO1: OSHW-LOGOM; OSHW-LOGO-M
R14, R18, R19, R20, R21, R22, R23, R24, R25, R26, R27, R28, R29, R30, R31, R32, R33, R34, R35, R36, R37, R38, R39, R40, R41, R42, R43, R44, R45, R46, R47, R60: 1k; R0805
X1, X5, X9, X10: PINHD_8_RND; 1X08
X6, X7: TACT_SWITCH; TACTILE_SWITCH_PTH_6.0MM

Connections:
+5V: LED39.A, R14.2, R18.2, R19.2, R47.2, X5.7; also elsewhere on the board
A0: LED1.A, X1.1; also elsewhere on the board
A1: LED2.A, X1.2; also elsewhere on the board
A2: LED3.A, X1.3; also elsewhere on the board
A3: LED4.A, X1.4; also elsewhere on the board
A4: LED5.A, X1.5; also elsewhere on the board
A5: LED6.A, X1.6; also elsewhere on the board
A6: LED7.A, X1.7; also elsewhere on the board
A7: LED8.A, X1.8; also elsewhere on the board
A8: LED9.A, X9.1; also elsewhere on the board
A9: LED10.A, X9.2; also elsewhere on the board
A10: LED11.A, X9.3; also elsewhere on the board
A11: LED12.A, X9.4; also elsewhere on the board
A12: LED13.A, X9.5; also elsewhere on the board
A13: LED14.A, X9.6; also elsewhere on the board
A14: LED15.A, X9.7; also elsewhere on the board
A15: LED16.A, X9.8; also elsewhere on the board
D0: LED17.A, X10.1; also elsewhere on the board
D1: LED18.A, X10.2; also elsewhere on the board
D2: LED19.A, X10.3; also elsewhere on the board
D3: LED20.A, X10.4; also elsewhere on the board
D4: LED21.A, X10.5; also elsewhere on the board
D5: LED22.A, X10.6; also elsewhere on the board
D6: LED23.A, X10.7; also elsewhere on the board
D7: LED24.A, X10.8; also elsewhere on the board
GND: R20.2, R21.2, R22.2, R23.2, R24.2, R25.2, R26.2, R27.2, R28.2, R29.2, R30.2, R31.2, R32.2, R33.2, R34.2, R35.2, R36.2, R37.2, R38.2, R39.2, R40.2, R41.2, R42.2, R43.2, R44.2, R45.2, R46.2, R60.2, X5.8, X6.3, X6.4, X7.3, X7.4; also elsewhere on the board
HALT_BTN: X7.1, X7.2; also elsewhere on the board
HALT_LED: LED34.A; also elsewhere on the board
IRQB: LED27.C, X5.4; also elsewhere on the board
unnamed: LED41.A, R14.1
unnamed: LED1.C, R21.1
unnamed: LED2.C, R22.1
unnamed: LED3.C, R23.1
unnamed: LED4.C, R24.1
unnamed: LED5.C, R25.1
unnamed: LED6.C, R26.1
unnamed: LED7.C, R27.1
unnamed: LED8.C, R28.1
unnamed: LED9.C, R29.1
unnamed: LED10.C, R30.1
unnamed: LED11.C, R31.1
unnamed: LED12.C, R32.1
unnamed: LED13.C, R33.1
unnamed: LED14.C, R34.1
unnamed: LED15.C, R35.1
unnamed: LED16.C, R36.1
unnamed: LED17.C, R37.1
unnamed: LED18.C, R38.1
unnamed: LED19.C, R39.1
unnamed: LED20.C, R40.1
unnamed: LED21.C, R41.1
unnamed: LED22.C, R42.1
unnamed: LED23.C, R43.1
unnamed: LED24.C, R44.1
unnamed: LED25.C, R45.1
unnamed: LED26.C, R46.1
unnamed: LED27.A, R47.1
unnamed: LED39.C, R60.1
unnamed: LED32.A, R18.1
unnamed: LED33.A, R19.1
unnamed: LED34.C, R20.1
NMIB: LED41.C, X5.3; also elsewhere on the board
PHI2: LED33.C, X5.5; also elsewhere on the board
RESB: LED32.C, X5.6, X6.1, X6.2; also elsewhere on the board
RWB: LED25.A, X5.1; also elsewhere on the board
SYNC: LED26.A, X5.2; also elsewhere on the board

Notes on the sheet:
Status LEDs and Connectors

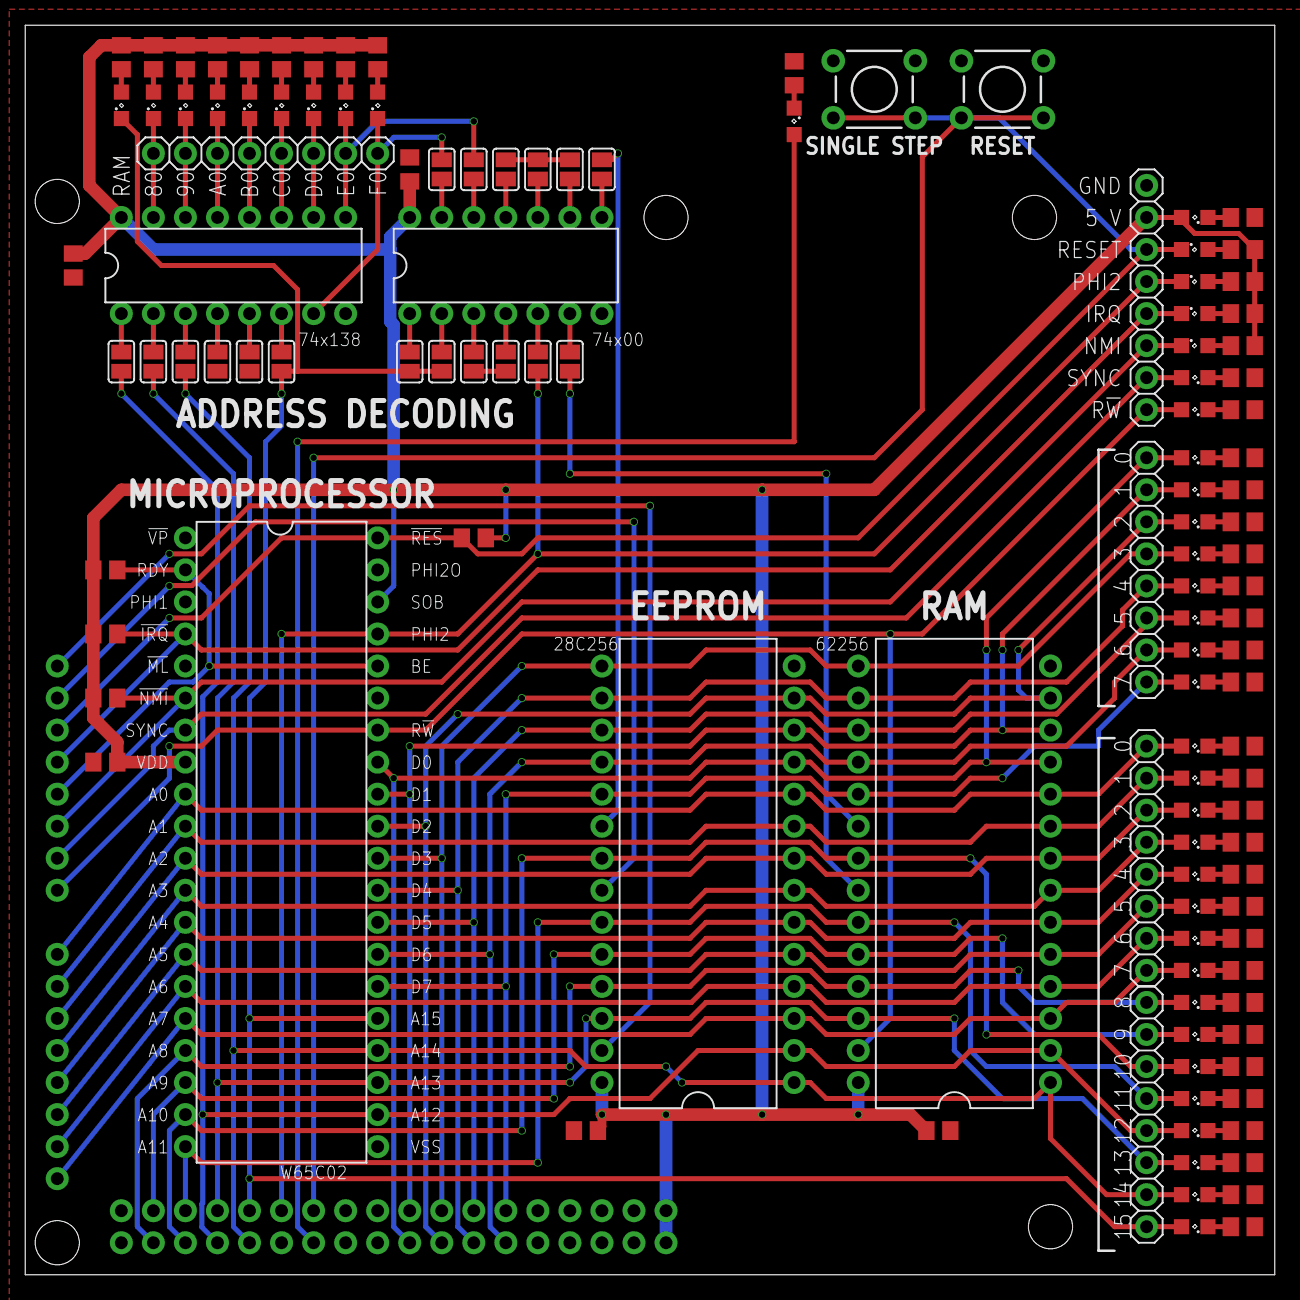
[picture p14: board eagle-6502/base v2/base.brd from above]

Board: 2 copper layers, 99.1 x 99.1 mm, 123 parts (0 on the bottom side), 108 nets.
