RobFro96/Arduino-Mega-6502/eagle-6502/base v1/base.brd

## EAGLE design eagle-6502/base v1/base.brd (2021-03-14, an earlier design)

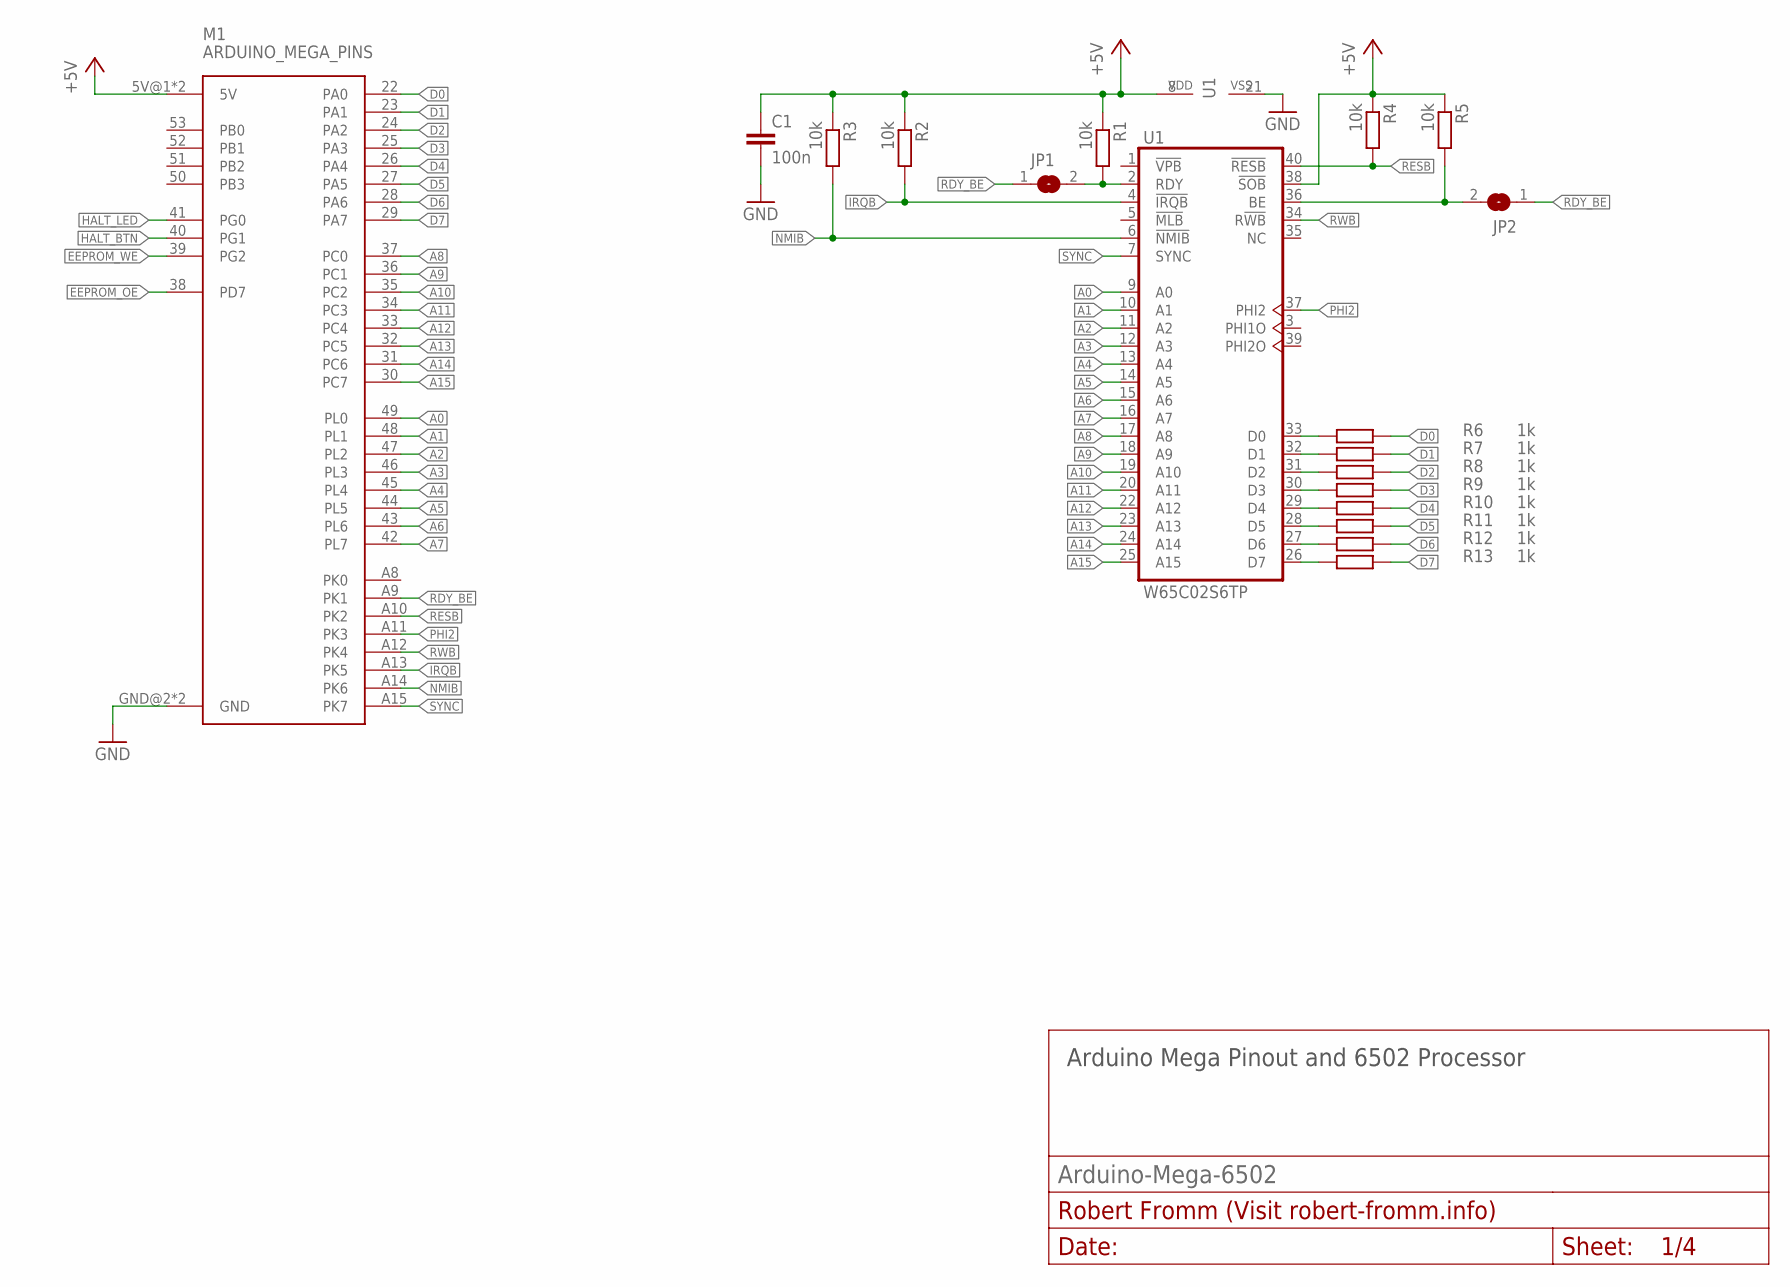
[picture p15: schematic base.sch, sheet 1]

Parts:
C1: 100n; C0805
JP1, JP2: SJ
M1: ARDUINO_MEGA_PINS
R1, R2, R3, R4, R5: 10k; R0805
R6, R7, R8, R9, R10, R11, R12, R13: 1k; R0805
U1: W65C02S6TP; DIL40

Connections:
+5V: C1.1, M1.5V@1 (5V), M1.5V@2 (5V), R1.1, R2.1, R3.1, R4.1, R5.1, U1.8 (VDD), U1.38 (!SOB); also elsewhere on the board
A0: M1.49 (PL0), U1.9 (A0); also elsewhere on the board
A1: M1.48 (PL1), U1.10 (A1); also elsewhere on the board
A2: M1.47 (PL2), U1.11 (A2); also elsewhere on the board
A3: M1.46 (PL3), U1.12 (A3); also elsewhere on the board
A4: M1.45 (PL4), U1.13 (A4); also elsewhere on the board
A5: M1.44 (PL5), U1.14 (A5); also elsewhere on the board
A6: M1.43 (PL6), U1.15 (A6); also elsewhere on the board
A7: M1.42 (PL7), U1.16 (A7); also elsewhere on the board
A8: M1.37 (PC0), U1.17 (A8); also elsewhere on the board
A9: M1.36 (PC1), U1.18 (A9); also elsewhere on the board
A10: M1.35 (PC2), U1.19 (A10); also elsewhere on the board
A11: M1.34 (PC3), U1.20 (A11); also elsewhere on the board
A12: M1.33 (PC4), U1.22 (A12); also elsewhere on the board
A13: M1.32 (PC5), U1.23 (A13); also elsewhere on the board
A14: M1.31 (PC6), U1.24 (A14); also elsewhere on the board
A15: M1.30 (PC7), U1.25 (A15); also elsewhere on the board
BE: JP2.2, R5.2, U1.36 (BE)
D0: M1.22 (PA0), R6.2; also elsewhere on the board
D1: M1.23 (PA1), R7.2; also elsewhere on the board
D2: M1.24 (PA2), R8.2; also elsewhere on the board
D3: M1.25 (PA3), R9.2; also elsewhere on the board
D4: M1.26 (PA4), R10.2; also elsewhere on the board
D5: M1.27 (PA5), R11.2; also elsewhere on the board
D6: M1.28 (PA6), R12.2; also elsewhere on the board
D7: M1.29 (PA7), R13.2; also elsewhere on the board
EEPROM_!OE: M1.38 (PD7); also elsewhere on the board
EEPROM_!WE: M1.39 (PG2); also elsewhere on the board
GND: C1.2, M1.GND@2 (GND), M1.GND@3 (GND), U1.21 (VSS); also elsewhere on the board
HALT_BTN: M1.40 (PG1); also elsewhere on the board
HALT_LED: M1.41 (PG0); also elsewhere on the board
IRQB: M1.A13 (PK5), R2.2, U1.4 (!IRQB); also elsewhere on the board
unnamed: R6.1, U1.33 (D0)
unnamed: R7.1, U1.32 (D1)
unnamed: R8.1, U1.31 (D2)
unnamed: R9.1, U1.30 (D3)
unnamed: R10.1, U1.29 (D4)
unnamed: R11.1, U1.28 (D5)
unnamed: R12.1, U1.27 (D6)
unnamed: R13.1, U1.26 (D7)
NMIB: M1.A14 (PK6), R3.2, U1.6 (!NMIB)
PHI2: M1.A11 (PK3), U1.37 (PHI2); also elsewhere on the board
RDY: JP1.2, R1.2, U1.2 (RDY)
RDY_BE: JP1.1, JP2.1, M1.A9 (PK1)
RESB: M1.A10 (PK2), R4.2, U1.40 (!RESB); also elsewhere on the board
RWB: M1.A12 (PK4), U1.34 (R!WB); also elsewhere on the board
SYNC: M1.A15 (PK7), U1.7 (SYNC); also elsewhere on the board

Notes on the sheet:
Arduino Mega Pinout and 6502 Processor

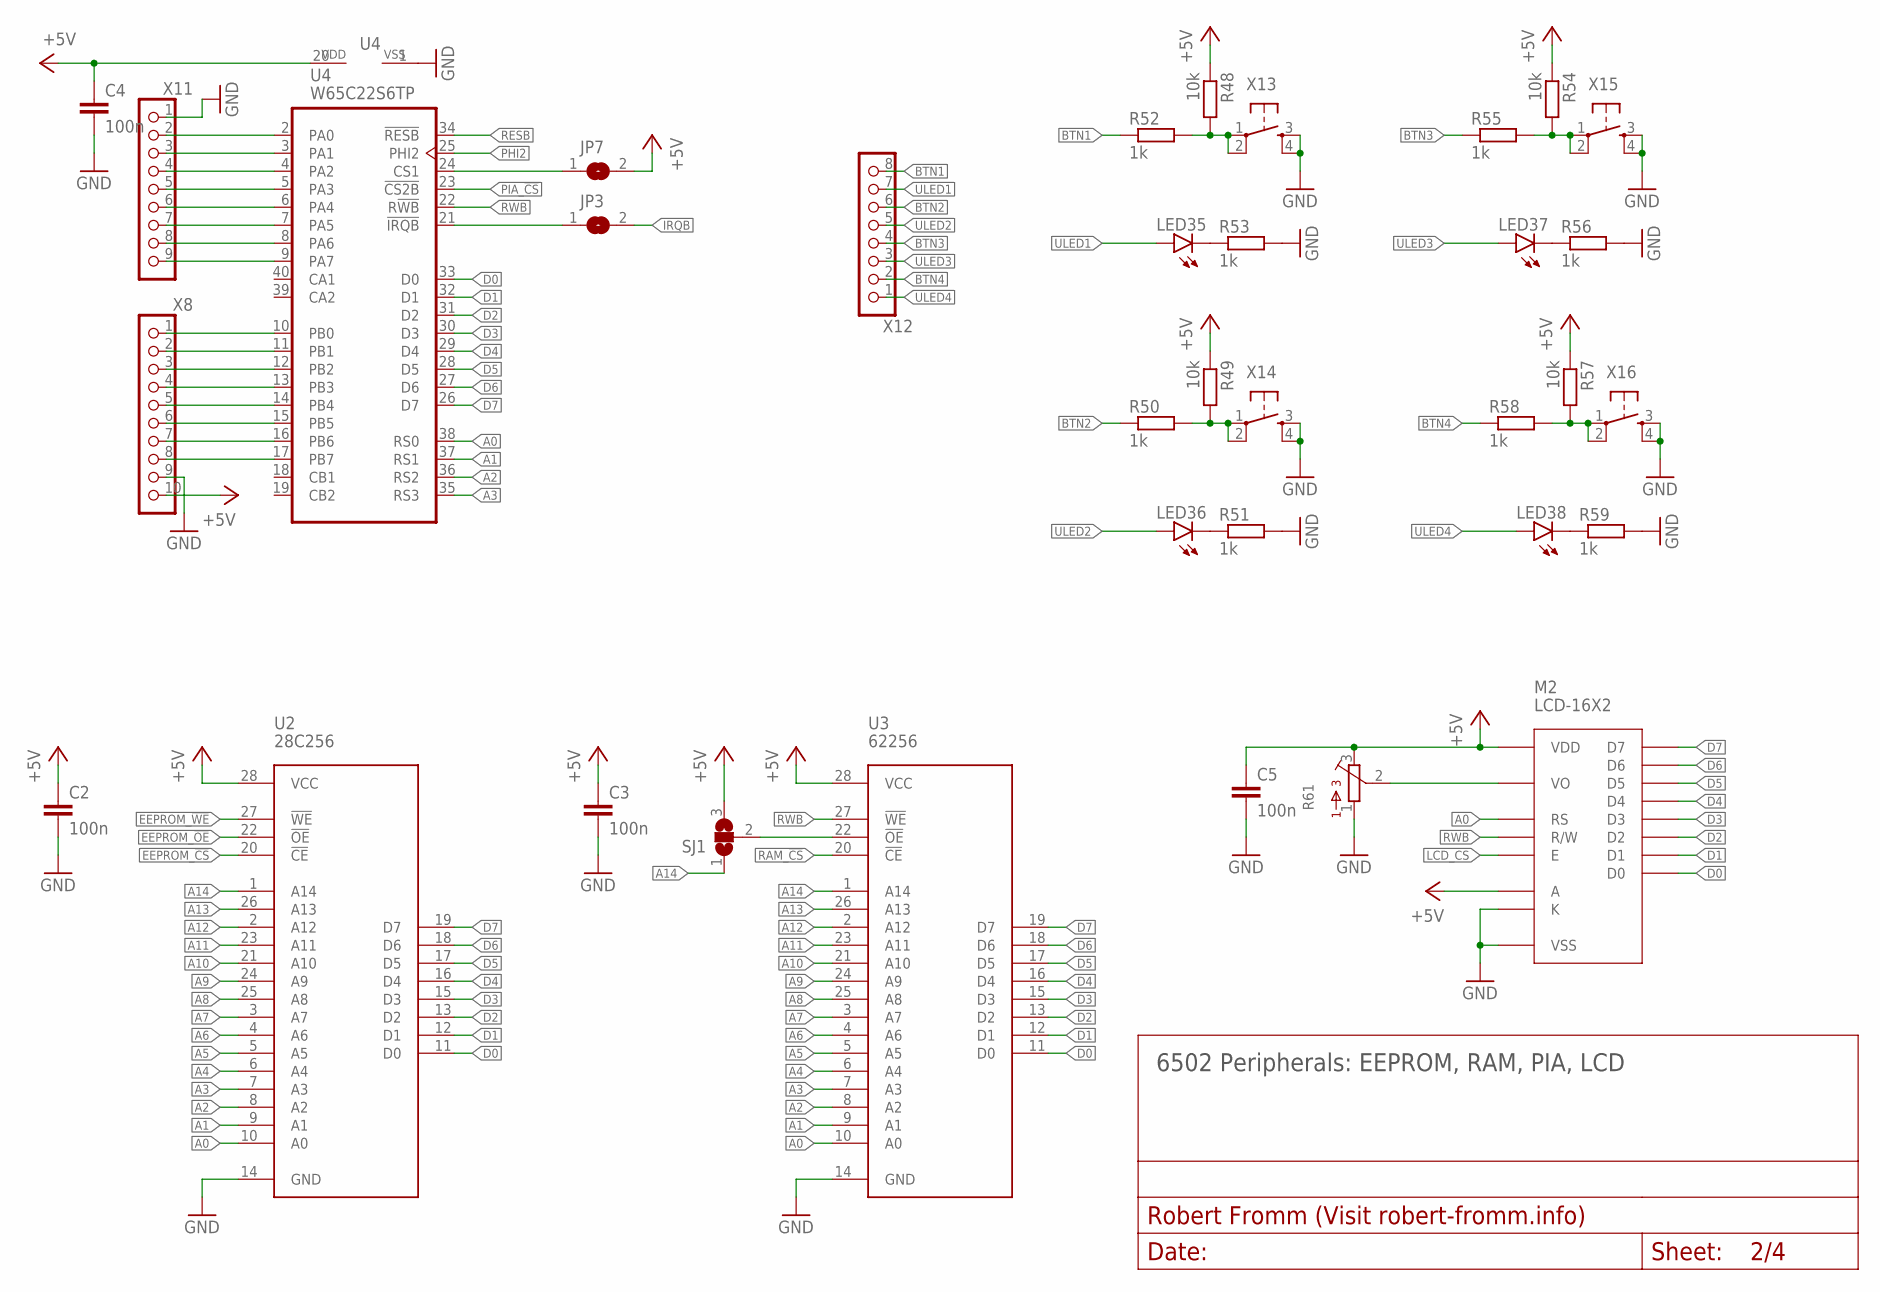
[picture p16: schematic base.sch, sheet 2]

Parts:
C2, C3, C4, C5: 100n; C0805
JP3, JP7: SJ
LED35, LED36, LED37, LED38: LEDSML0805; SML0805
M2: LCD-16X2
R48, R49, R54, R57: 10k; R0805
R50, R51, R52, R53, R55, R56, R58, R59: 1k; R0805
R61: 3362P
SJ1: SJ2W; SJ_2
U2: 28C256; DIL28-6
U3: 62256; DIL28-6
U4: W65C22S6TP; DIL40
X8: PINHD_10_RND; 1X10
X11: PINHD_9_RND; 1X09
X12: PINHD_8_RND; 1X08
X13, X14, X15, X16: TACT_SWITCH; TACTILE_SWITCH_PTH_6.0MM

Connections:
+5V: C2.1, C3.1, C4.1, C5.1, JP7.2, M2.2 (VDD), M2.15 (A), R48.1, R49.1, R54.1, R57.1, R61.3, SJ1.3, U2.28 (VCC), U3.28 (VCC), U4.20 (VDD), X8.10; also elsewhere on the board
A0: M2.4 (RS), U2.10 (A0), U3.10 (A0), U4.38 (RS0); also elsewhere on the board
A1: U2.9 (A1), U3.9 (A1), U4.37 (RS1); also elsewhere on the board
A2: U2.8 (A2), U3.8 (A2), U4.36 (RS2); also elsewhere on the board
A3: U2.7 (A3), U3.7 (A3), U4.35 (RS3); also elsewhere on the board
A4: U2.6 (A4), U3.6 (A4); also elsewhere on the board
A5: U2.5 (A5), U3.5 (A5); also elsewhere on the board
A6: U2.4 (A6), U3.4 (A6); also elsewhere on the board
A7: U2.3 (A7), U3.3 (A7); also elsewhere on the board
A8: U2.25 (A8), U3.25 (A8); also elsewhere on the board
A9: U2.24 (A9), U3.24 (A9); also elsewhere on the board
A10: U2.21 (A10), U3.21 (A10); also elsewhere on the board
A11: U2.23 (A11), U3.23 (A11); also elsewhere on the board
A12: U2.2 (A12), U3.2 (A12); also elsewhere on the board
A13: U2.26 (A13), U3.26 (A13); also elsewhere on the board
A14: SJ1.1, U2.1 (A14), U3.1 (A14); also elsewhere on the board
BTN1: R52.1, X12.8
BTN2: R50.1, X12.6
BTN3: R55.1, X12.4
BTN4: R58.1, X12.2
D0: M2.7 (D0), U2.11 (D0), U3.11 (D0), U4.33 (D0); also elsewhere on the board
D1: M2.8 (D1), U2.12 (D1), U3.12 (D1), U4.32 (D1); also elsewhere on the board
D2: M2.9 (D2), U2.13 (D2), U3.13 (D2), U4.31 (D2); also elsewhere on the board
D3: M2.10 (D3), U2.15 (D3), U3.15 (D3), U4.30 (D3); also elsewhere on the board
D4: M2.11 (D4), U2.16 (D4), U3.16 (D4), U4.29 (D4); also elsewhere on the board
D5: M2.12 (D5), U2.17 (D5), U3.17 (D5), U4.28 (D5); also elsewhere on the board
D6: M2.13 (D6), U2.18 (D6), U3.18 (D6), U4.27 (D6); also elsewhere on the board
D7: M2.14 (D7), U2.19 (D7), U3.19 (D7), U4.26 (D7); also elsewhere on the board
EEPROM_!CS: U2.20 (!CE); also elsewhere on the board
EEPROM_!OE: U2.22 (!OE); also elsewhere on the board
EEPROM_!WE: U2.27 (!WE); also elsewhere on the board
GND: C2.2, C3.2, C4.2, C5.2, M2.1 (VSS), M2.16 (K), R51.2, R53.2, R56.2, R59.2, R61.1, U2.14 (GND), U3.14 (GND), U4.1 (VSS), X8.9, X11.1, X13.3, X13.4, X14.3, X14.4, X15.3, X15.4, X16.3, X16.4; also elsewhere on the board
IRQB: JP3.2; also elsewhere on the board
LCD_CS: M2.6 (E); also elsewhere on the board
unnamed: SJ1.2, U3.22 (!OE)
unnamed: JP3.1, U4.21 (!IRQB)
unnamed: U4.2 (PA0), X11.2
unnamed: U4.3 (PA1), X11.3
unnamed: U4.4 (PA2), X11.4
unnamed: U4.5 (PA3), X11.5
unnamed: U4.6 (PA4), X11.6
unnamed: U4.7 (PA5), X11.7
unnamed: U4.8 (PA6), X11.8
unnamed: U4.9 (PA7), X11.9
unnamed: U4.10 (PB0), X8.1
unnamed: U4.11 (PB1), X8.2
unnamed: U4.12 (PB2), X8.3
unnamed: U4.13 (PB3), X8.4
unnamed: U4.14 (PB4), X8.5
unnamed: U4.15 (PB5), X8.6
unnamed: U4.16 (PB6), X8.7
unnamed: U4.17 (PB7), X8.8
unnamed: R48.2, R52.2, X13.1, X13.2
unnamed: LED35.C, R53.1
unnamed: R49.2, R50.2, X14.1, X14.2
unnamed: LED36.C, R51.1
unnamed: R54.2, R55.2, X15.1, X15.2
unnamed: LED37.C, R56.1
unnamed: R57.2, R58.2, X16.1, X16.2
unnamed: JP7.1, U4.24 (CS1)
unnamed: M2.3 (VO), R61.2
unnamed: LED38.C, R59.1
PHI2: U4.25 (PHI2); also elsewhere on the board
PIA_!CS: U4.23 (!CS2B); also elsewhere on the board
RAM_!CS: U3.20 (!CE); also elsewhere on the board
RESB: U4.34 (!RESB); also elsewhere on the board
RWB: M2.5 (R/W), U3.27 (!WE), U4.22 (R!WB); also elsewhere on the board
ULED1: LED35.A, X12.7
ULED2: LED36.A, X12.5
ULED3: LED37.A, X12.3
ULED4: LED38.A, X12.1

Notes on the sheet:
6502 Peripherals: EEPROM, RAM, PIA, LCD

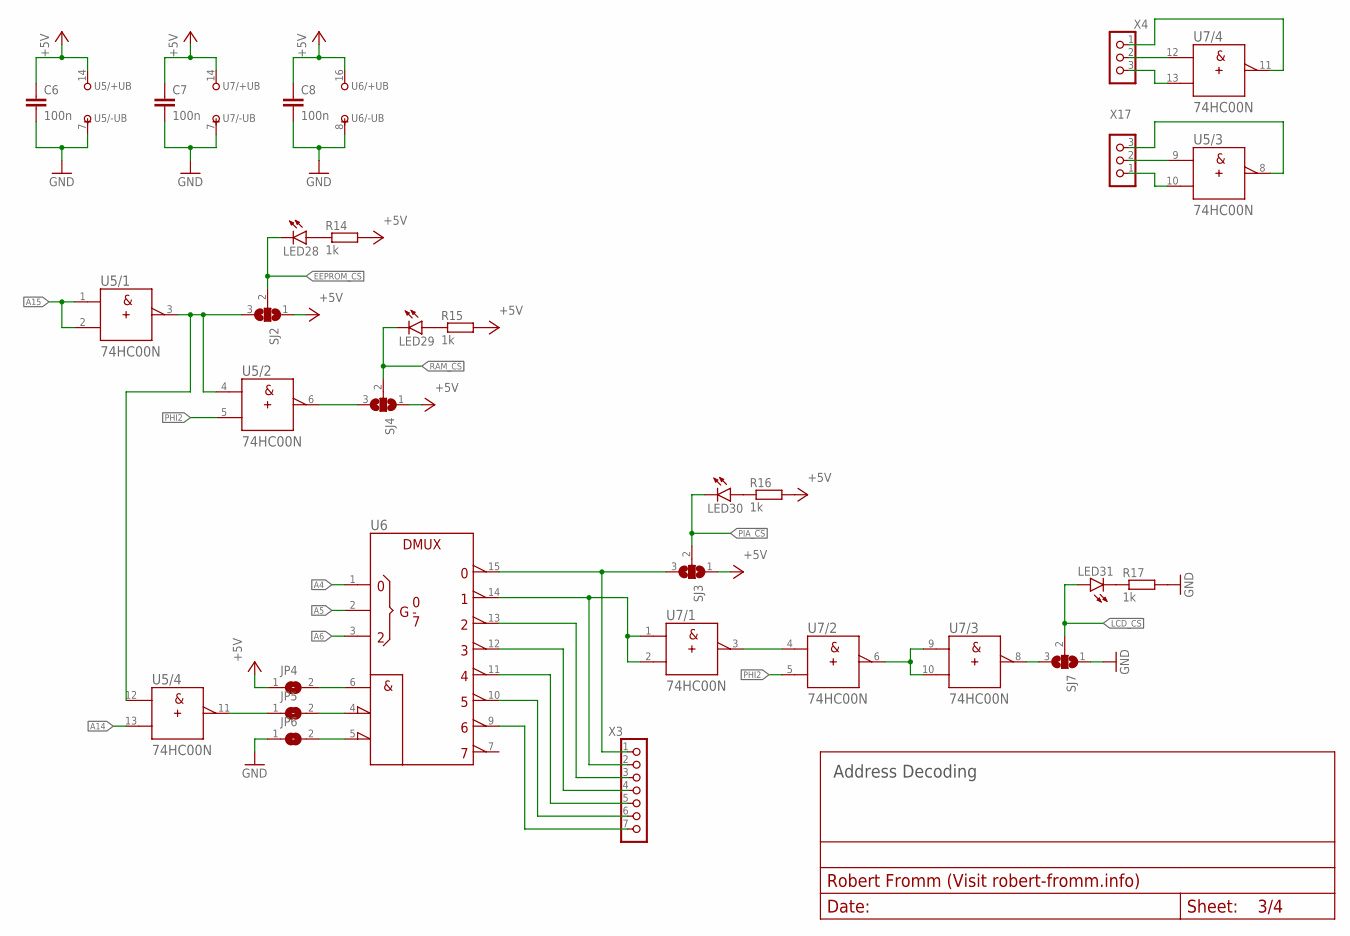
[picture p17: schematic base.sch, sheet 3]

Parts:
C6, C7, C8: 100n; C0805
JP4, JP5, JP6: SJ
LED28, LED29, LED30, LED31: LEDSML0805; SML0805
R14, R15, R16, R17: 1k; R0805
SJ2, SJ3, SJ4, SJ7: SJ2W; SJ_2
U5, U7: 74HC00N; DIL14
U6: 74138N; DIL16
X3: PINHD_7_RND; 1X07
X4, X17: PINHD_3_RND; 1X03

Connections:
+5V: C6.1, C7.1, C8.1, JP4.1, R14.2, R15.2, R16.2, SJ2.1, SJ3.1, SJ4.1, U5.14 (+UB), U6.16 (+UB), U7.14 (+UB); also elsewhere on the board
A4: U6.1 (A); also elsewhere on the board
A5: U6.2 (B); also elsewhere on the board
A6: U6.3 (C); also elsewhere on the board
A14: U5.13 (B); also elsewhere on the board
A15: U5.1 (A), U5.2 (B); also elsewhere on the board
EEPROM_!CS: LED28.C, SJ2.2; also elsewhere on the board
GND: C6.2, C7.2, C8.2, JP6.1, R17.2, SJ7.1, U5.7 (-UB), U6.8 (-UB), U7.7 (-UB); also elsewhere on the board
LCD_CS: LED31.A, SJ7.2; also elsewhere on the board
unnamed: U5.8 (Y), X17.3
unnamed: U5.9 (A), X17.2
unnamed: SJ2.3, U5.3 (Y), U5.4 (A), U5.12 (A)
unnamed: SJ4.3, U5.6 (Y)
unnamed: SJ3.3, U6.15 (Y0), X3.1
unnamed: JP4.2, U6.6 (G1)
unnamed: JP5.1, U5.11 (Y)
unnamed: JP6.2, U6.5 (!G2B)
unnamed: U6.14 (Y1), U7.1 (A), U7.2 (B), X3.2
unnamed: U7.3 (Y), U7.4 (A)
unnamed: U7.6 (Y), U7.9 (A), U7.10 (B)
unnamed: SJ7.3, U7.8 (Y)
unnamed: LED28.A, R14.1
unnamed: LED29.A, R15.1
unnamed: LED30.A, R16.1
unnamed: U5.10 (B), X17.1
unnamed: JP5.2, U6.4 (!G2A)
unnamed: U6.12 (Y3), X3.4
unnamed: U6.11 (Y4), X3.5
unnamed: U6.13 (Y2), X3.3
unnamed: U6.10 (Y5), X3.6
unnamed: U6.9 (Y6), X3.7
unnamed: LED31.C, R17.1
unnamed: U7.11 (Y), X4.1
unnamed: U7.12 (A), X4.2
unnamed: U7.13 (B), X4.3
PHI2: U5.5 (B), U7.5 (B); also elsewhere on the board
PIA_!CS: LED30.C, SJ3.2; also elsewhere on the board
RAM_!CS: LED29.C, SJ4.2; also elsewhere on the board

Notes on the sheet:
Address Decoding

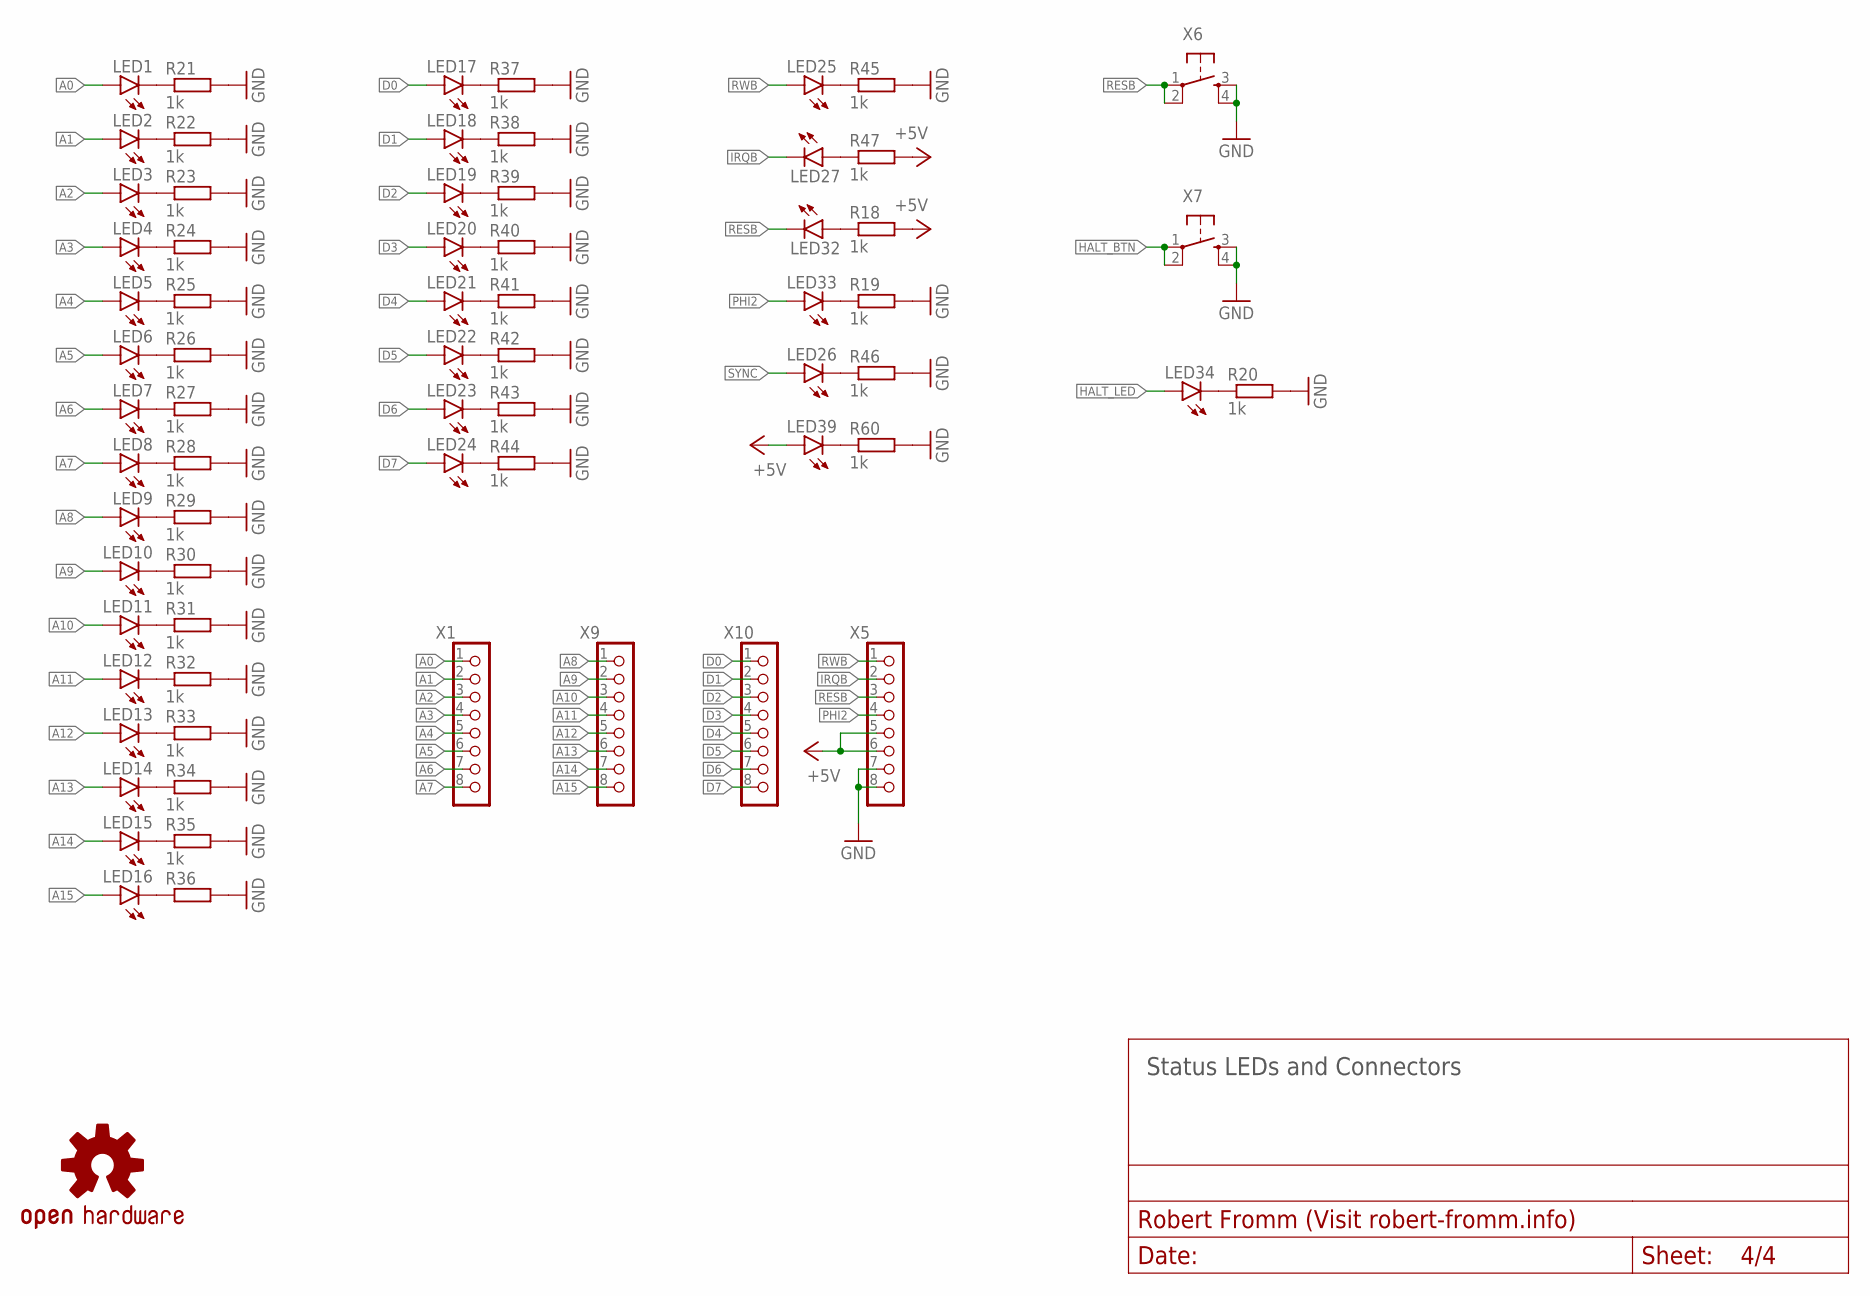
[picture p18: schematic base.sch, sheet 4]

Parts:
LED1, LED2, LED3, LED4, LED5, LED6, LED7, LED8, LED9, LED10, LED11, LED12, LED13, LED14, LED15, LED16, LED17, LED18, LED19, LED20, LED21, LED22, LED23, LED24, LED25, LED26, LED27, LED32, LED33, LED34, LED39: LEDSML0805; SML0805
LOGO1: OSHW-LOGOM; OSHW-LOGO-M
R18, R19, R20, R21, R22, R23, R24, R25, R26, R27, R28, R29, R30, R31, R32, R33, R34, R35, R36, R37, R38, R39, R40, R41, R42, R43, R44, R45, R46, R47, R60: 1k; R0805
X1, X5, X9, X10: PINHD_8_RND; 1X08
X6, X7: TACT_SWITCH; TACTILE_SWITCH_PTH_6.0MM

Connections:
+5V: LED39.A, R18.2, R47.2, X5.5, X5.6; also elsewhere on the board
A0: LED1.A, X1.1; also elsewhere on the board
A1: LED2.A, X1.2; also elsewhere on the board
A2: LED3.A, X1.3; also elsewhere on the board
A3: LED4.A, X1.4; also elsewhere on the board
A4: LED5.A, X1.5; also elsewhere on the board
A5: LED6.A, X1.6; also elsewhere on the board
A6: LED7.A, X1.7; also elsewhere on the board
A7: LED8.A, X1.8; also elsewhere on the board
A8: LED9.A, X9.1; also elsewhere on the board
A9: LED10.A, X9.2; also elsewhere on the board
A10: LED11.A, X9.3; also elsewhere on the board
A11: LED12.A, X9.4; also elsewhere on the board
A12: LED13.A, X9.5; also elsewhere on the board
A13: LED14.A, X9.6; also elsewhere on the board
A14: LED15.A, X9.7; also elsewhere on the board
A15: LED16.A, X9.8; also elsewhere on the board
D0: LED17.A, X10.1; also elsewhere on the board
D1: LED18.A, X10.2; also elsewhere on the board
D2: LED19.A, X10.3; also elsewhere on the board
D3: LED20.A, X10.4; also elsewhere on the board
D4: LED21.A, X10.5; also elsewhere on the board
D5: LED22.A, X10.6; also elsewhere on the board
D6: LED23.A, X10.7; also elsewhere on the board
D7: LED24.A, X10.8; also elsewhere on the board
GND: R19.2, R20.2, R21.2, R22.2, R23.2, R24.2, R25.2, R26.2, R27.2, R28.2, R29.2, R30.2, R31.2, R32.2, R33.2, R34.2, R35.2, R36.2, R37.2, R38.2, R39.2, R40.2, R41.2, R42.2, R43.2, R44.2, R45.2, R46.2, R60.2, X5.7, X5.8, X6.3, X6.4, X7.3, X7.4; also elsewhere on the board
HALT_BTN: X7.1, X7.2; also elsewhere on the board
HALT_LED: LED34.A; also elsewhere on the board
IRQB: LED27.C, X5.2; also elsewhere on the board
unnamed: LED1.C, R21.1
unnamed: LED2.C, R22.1
unnamed: LED3.C, R23.1
unnamed: LED4.C, R24.1
unnamed: LED5.C, R25.1
unnamed: LED6.C, R26.1
unnamed: LED7.C, R27.1
unnamed: LED8.C, R28.1
unnamed: LED9.C, R29.1
unnamed: LED10.C, R30.1
unnamed: LED11.C, R31.1
unnamed: LED12.C, R32.1
unnamed: LED13.C, R33.1
unnamed: LED14.C, R34.1
unnamed: LED15.C, R35.1
unnamed: LED16.C, R36.1
unnamed: LED17.C, R37.1
unnamed: LED18.C, R38.1
unnamed: LED19.C, R39.1
unnamed: LED20.C, R40.1
unnamed: LED21.C, R41.1
unnamed: LED22.C, R42.1
unnamed: LED23.C, R43.1
unnamed: LED24.C, R44.1
unnamed: LED25.C, R45.1
unnamed: LED26.C, R46.1
unnamed: LED27.A, R47.1
unnamed: LED39.C, R60.1
unnamed: LED32.A, R18.1
unnamed: LED33.C, R19.1
unnamed: LED34.C, R20.1
PHI2: LED33.A, X5.4; also elsewhere on the board
RESB: LED32.C, X5.3, X6.1, X6.2; also elsewhere on the board
RWB: LED25.A, X5.1; also elsewhere on the board
SYNC: LED26.A; also elsewhere on the board

Notes on the sheet:
Status LEDs and Connectors

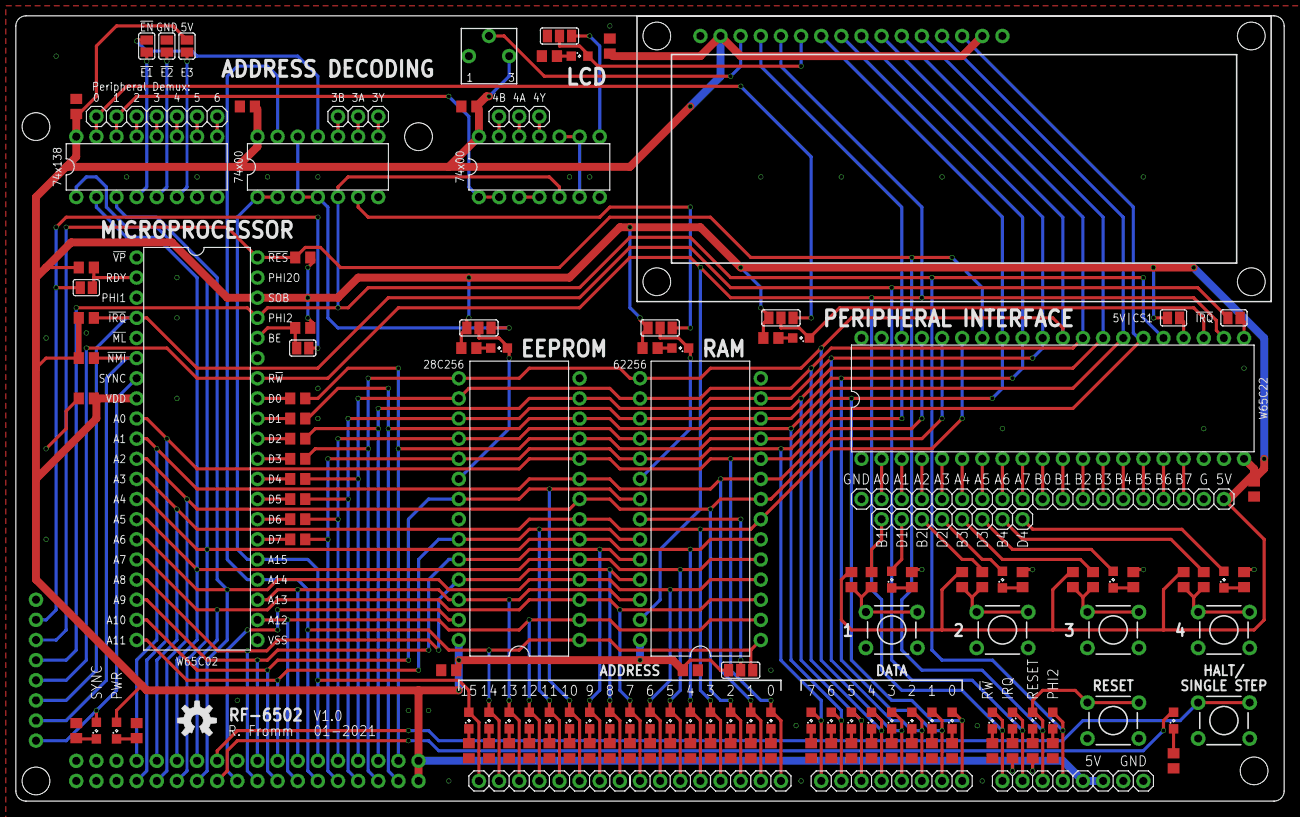
[picture p19: board eagle-6502/base v1/base.brd from above]

Board: 2 copper layers, 160.0 x 99.1 mm, 146 parts (0 on the bottom side), 144 nets.
