RobFro96/Arduino-Mega-6502/term-6502/asm/todo_fix_addr_decoder/040_bitmanipulation.asm

ORB = 0x7F00
ORA = 0x7F01
DDRB = 0x7F02
DDRA = 0x7F03

LED1 = 0x02
LED2 = 0x08
LED3 = 0x20
LED4 = 0x80

    .org 0x8000
reset:
    lda #(LED1 + LED2 + LED3 + LED4)
    sta DDRA

loop:
    lda ORA
    ora #LED1
    sta ORA ; LED1 on

    lda ORA
    eor #LED2
    sta ORA ; LED2 toogle

    lda ORA
    and #~LED1 ; LED1 off
    sta ORA

    lda ORA
    eor #LED2
    sta ORA ; LED2 toogle

    jmp loop

    .org 0xFFFC
    .word reset
