RobFro96/Arduino-Mega-6502/term-6502/asm/todo_fix_addr_decoder/061_ram_decoder.asm

ORB = 0x7F00
ORA = 0x7F01
DDRB = 0x7F02
DDRA = 0x7F03

LED1 = 0x02
LED2 = 0x08
LED3 = 0x20
LED4 = 0x80

    .org 0x8000
reset:
    lda #0xFF
    sta 0x00
    sta 0x0100
    sta 0x0200
    sta 0x3FFF
    sta 0x4000
    lda 0x4000
loop:
    jmp loop

    .org $FFFC
    .word reset
