RobFro96/Arduino-Mega-6502/(commit log)

2021-02-06 In-Cicruit EEPROM Programmer: Arduino Program
2021-02-07 Terminal Feature Complete
    [base.brd, base.sch]
2021-03-14 Updated Schematic, Added PDF
    [base.brd, base.sch]
2021-03-14 Updated Schematic PDF
2023-12-06 Added Eagle Version 2 hardware design
    [base.brd, base.sch, purchase_2021-01-21.brd]
2023-12-07 Added EEPROM programmer (see Ben Eater)
    [eater_eeprom.brd, eater_eeprom.sch]
2023-12-08 EEPROM Programmer working over UART
2023-12-09 Added Assembler and Programm Python CLI
2024-01-01 Porting WozMon to work with software UART
2024-01-03 Removed assembled .bin files
2024-01-05 Added UART_CONF to configure UART: upper case only, disable echo, only output important echos
2024-01-05 Reconfigured write protect as boot button
2024-01-10 First version of 6502 Arduino PCB
    [6502_arduino.brd, 6502_arduino.sch]
2024-01-12 Tested PCB design on breadboard, added BAT54A ORing on 74x138 lines to allow stack served by RIOT, ORing of UART status LEDs
    [6502_arduino.brd, 6502_arduino.sch]
2024-02-25 Populated and tested PCB. Added fixes in robfro_wozmon and Errata list of PCB errors
    [6502_arduino.brd]
